harryiliffe/interactive-wall/README.md

# Interactive Wall
A flexible system for creating an interactive wall
