harryiliffe/interactive-wall/docs/_pages/language.md

---
title: "Language"
layout: default
---

# Interactive Wall component names

##### Module
Each individual physical component.
e.g Button Module, Hub Module e.t.c.

##### Compute Hub
esp32 + power regulation

##### Capacitive Hub
Capacitive touch board

##### Button
The module that has the capacitive touch button and workshop title.

# Fab Lab WGTN sessions

### Intros
 * about fab tour
 * designing for additive and subtractive
 * open blogging
 * illustrator for digital fabrication

 * intro to laser cutting

 * intro to 3d printing
 * intro to digital embroidery
 * intro to glitch knit
 * cnc milling software
 * cnc milling wax mill
 * cnc milling shopbot
 * intro to tensile tester
 * intro to electronics
 * intro to programming
 * intro to 3d scanning
 * intro to vinyl cutting
 * circuit design and production

### Machines

 * vinyl cutter
 * laser cutter
 * 3d printer
 * MDX-40
 * MDX-20
 * embroidery machine
 * glitch knit
 * 3d scanner
 * tensile tester
