harryiliffe/interactive-wall/boards/button module/exports/button-v1-mask.png

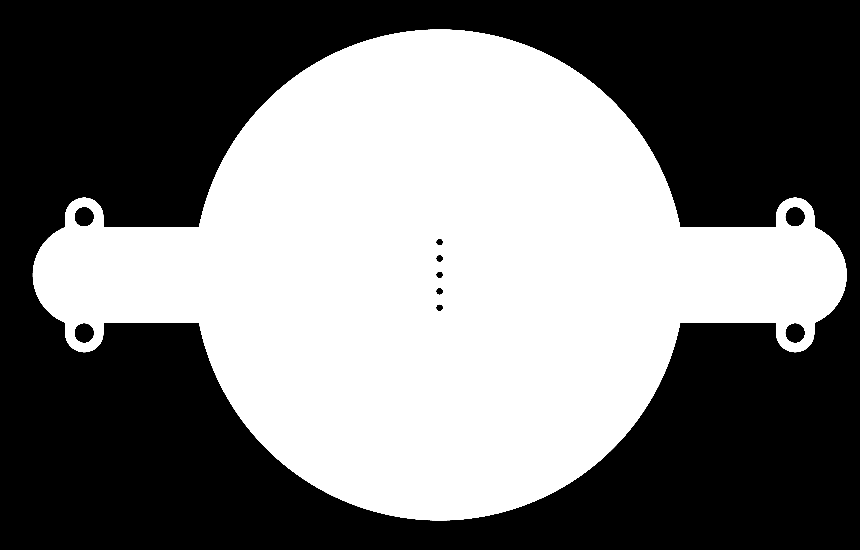
boards/button module/exports/button-v1-mask.png
