harryiliffe/interactive-wall/boards/button module/exports/button-v1-trace.png

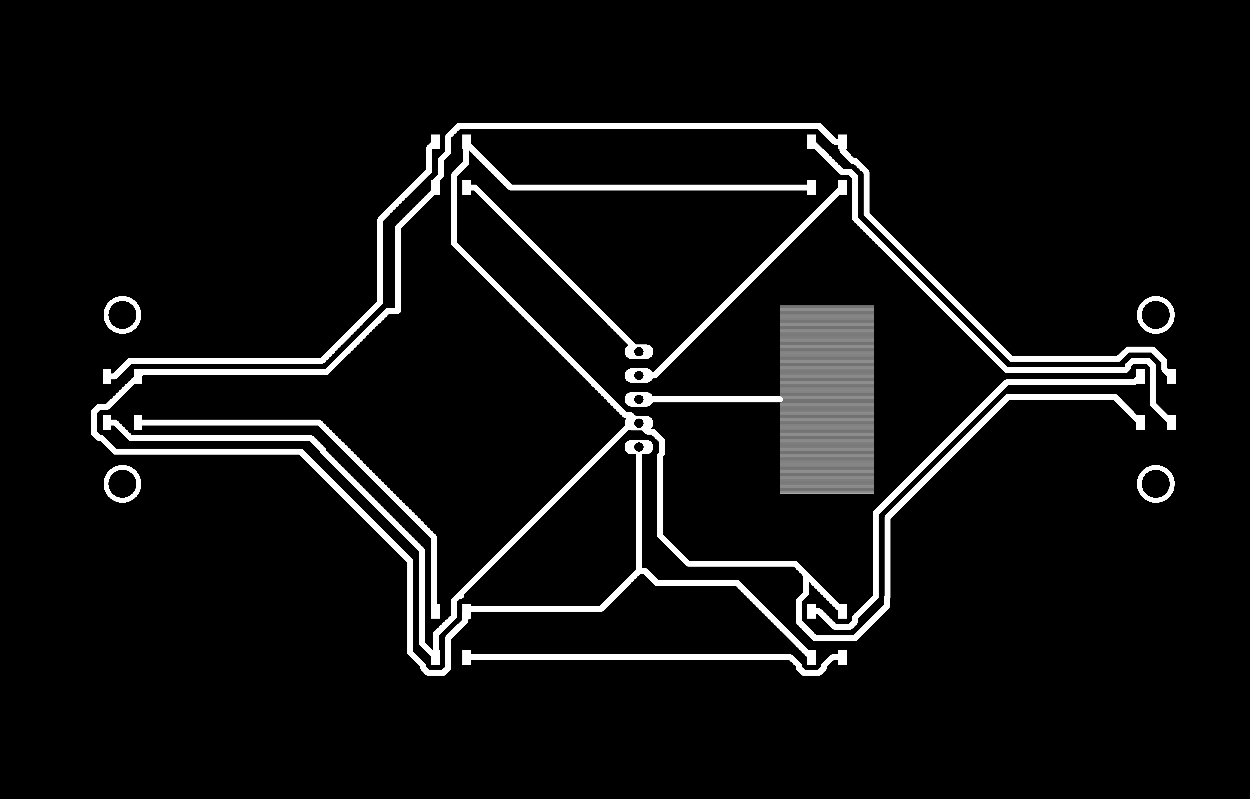
boards/button module/exports/button-v1-trace.png
