harryiliffe/interactive-wall/boards/button module/exports/button-v2-mask.png

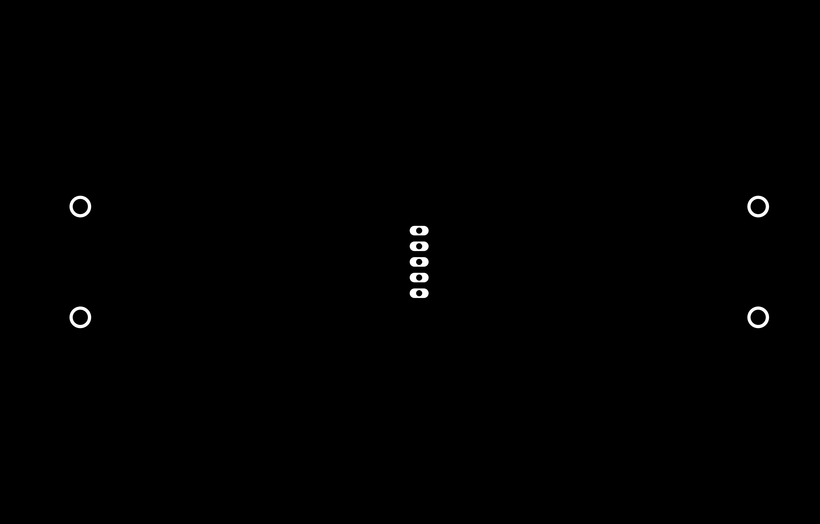
boards/button module/exports/button-v2-mask.png
