harryiliffe/interactive-wall/boards/button module/exports/button-v2-trace.png

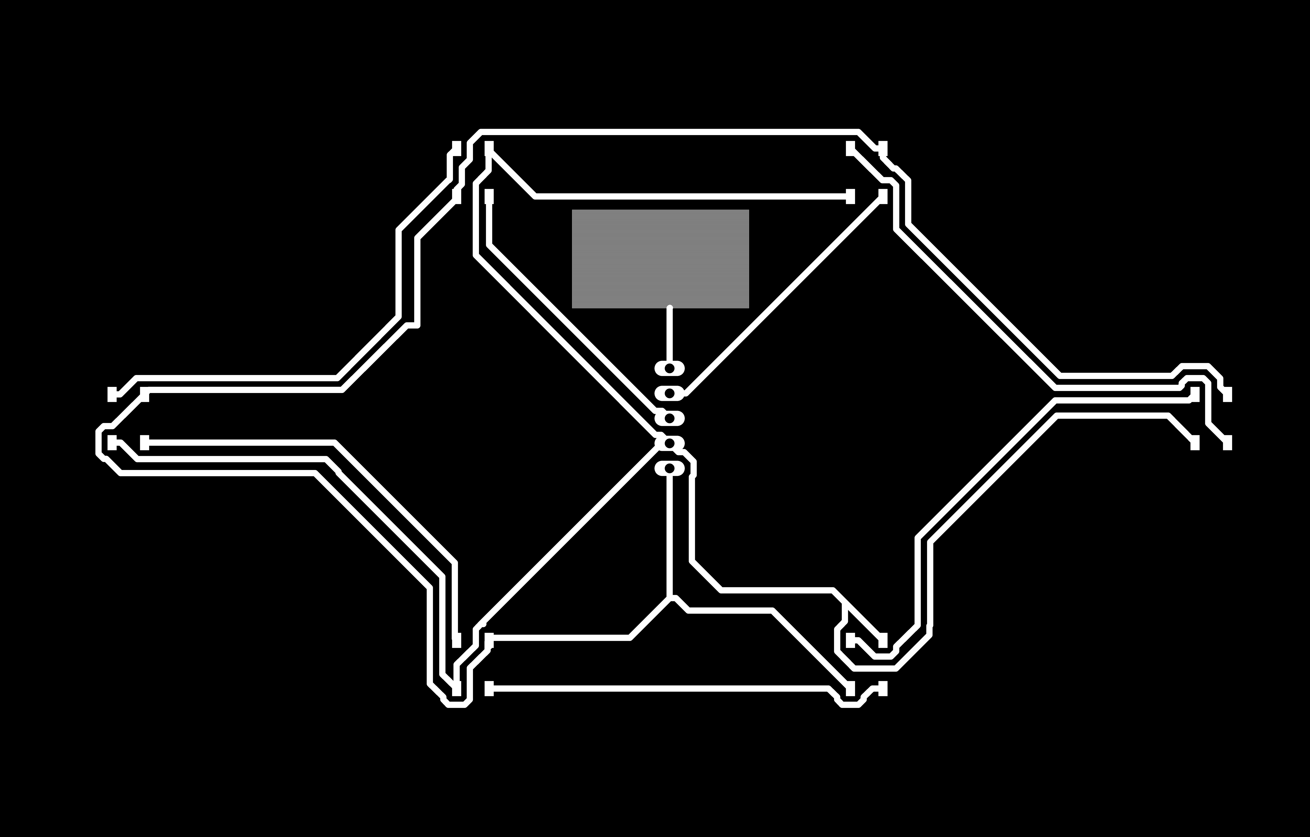
boards/button module/exports/button-v2-trace.png
