harryiliffe/interactive-wall/boards/capactive hub/export/cap_hub-v1-mask.png

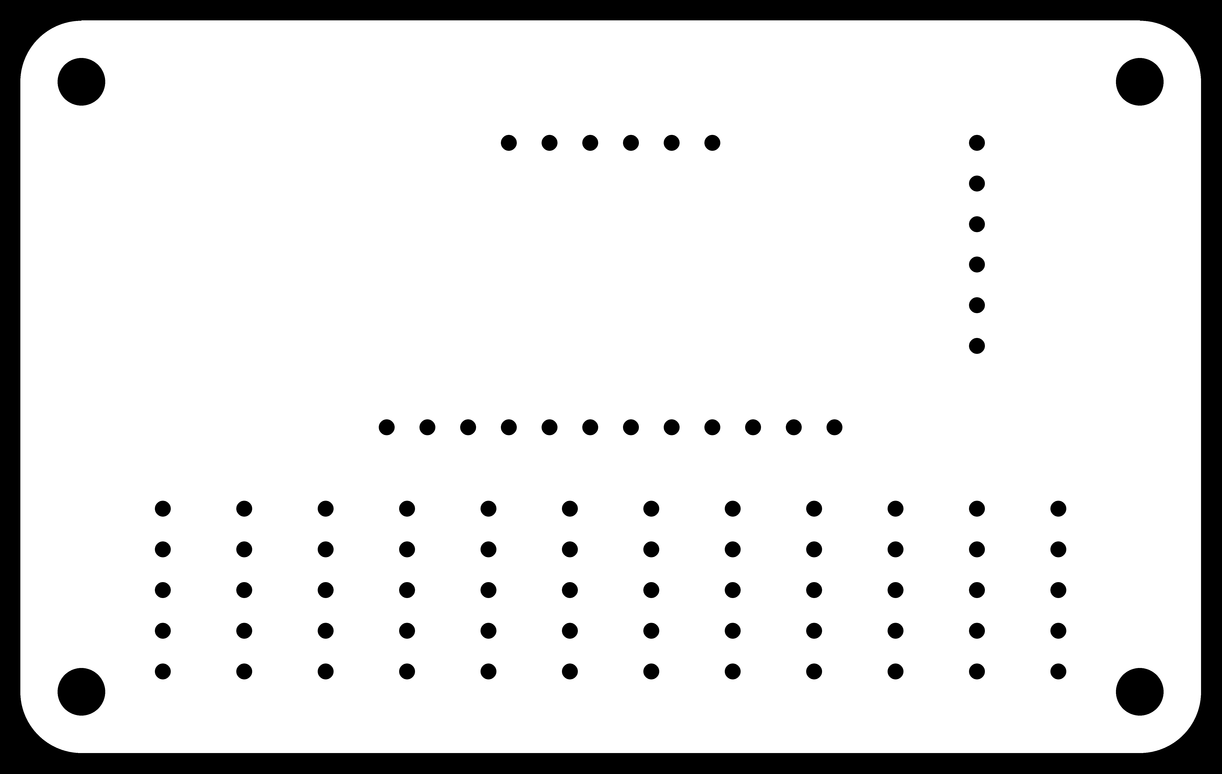
boards/capactive hub/export/cap_hub-v1-mask.png
