harryiliffe/interactive-wall/boards/capactive hub/export/cap_hub-v1-trace.png

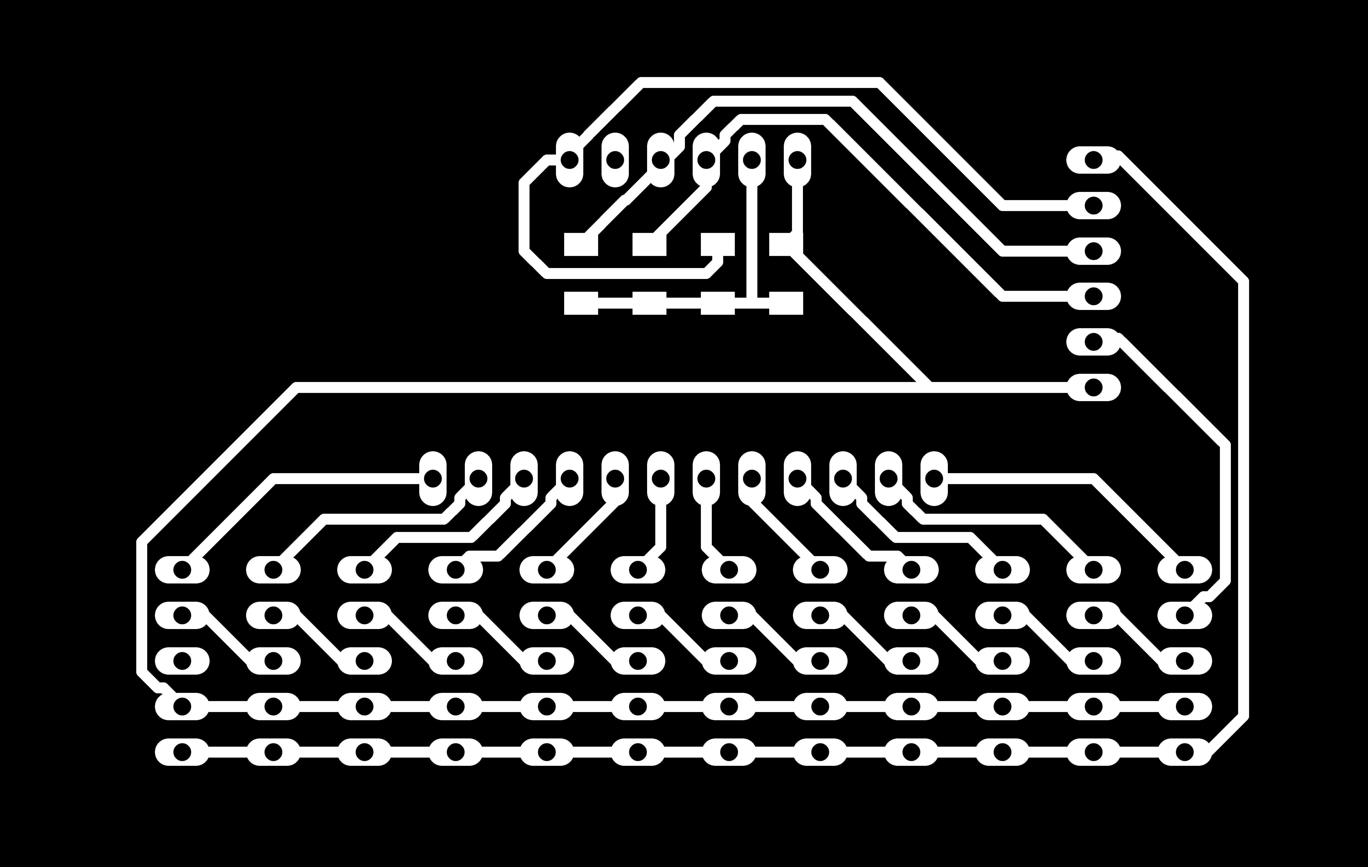
boards/capactive hub/export/cap_hub-v1-trace.png
