harryiliffe/interactive-wall/boards/capactive hub/export/cap_hub-v2-trace.png

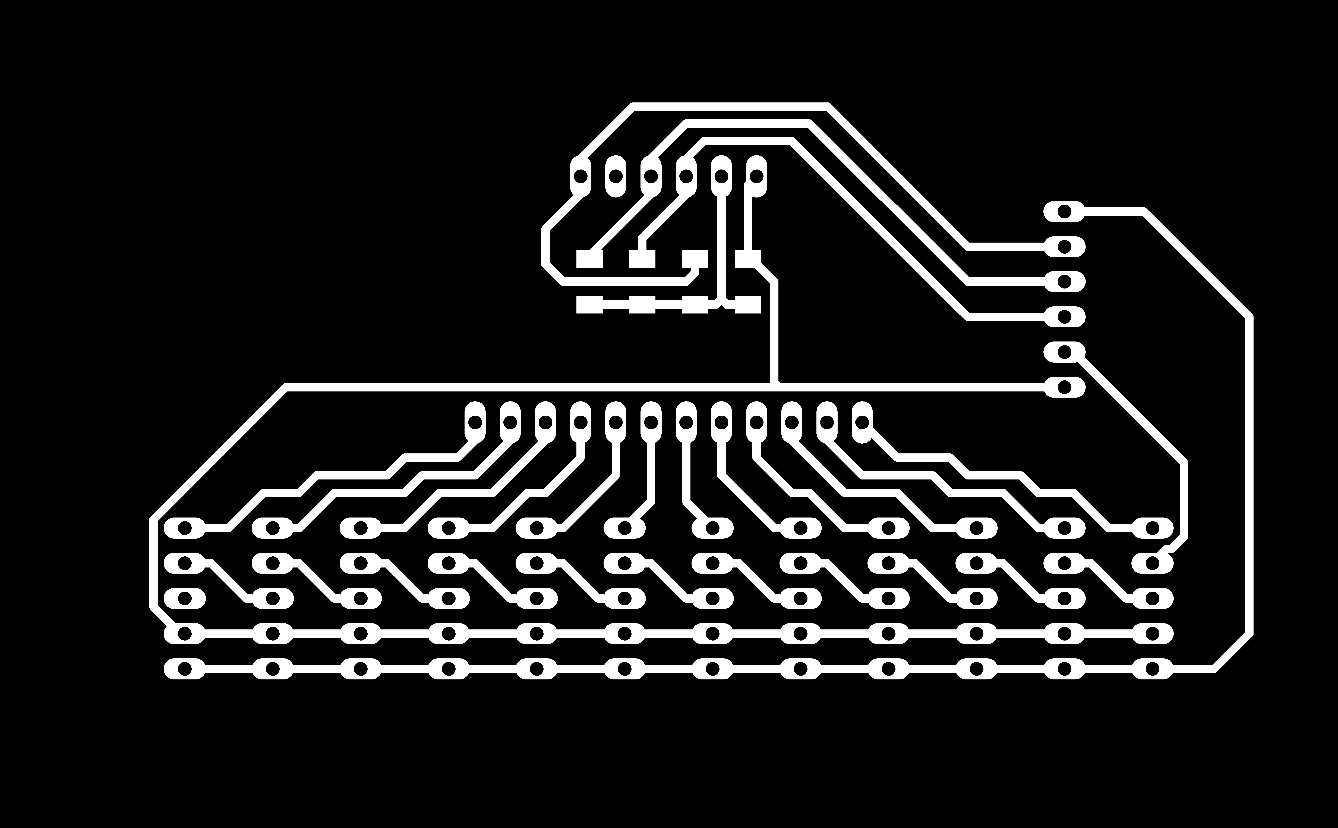
boards/capactive hub/export/cap_hub-v2-trace.png
