harryiliffe/interactive-wall/boards/compute hub - atmega/exports/computehub.png

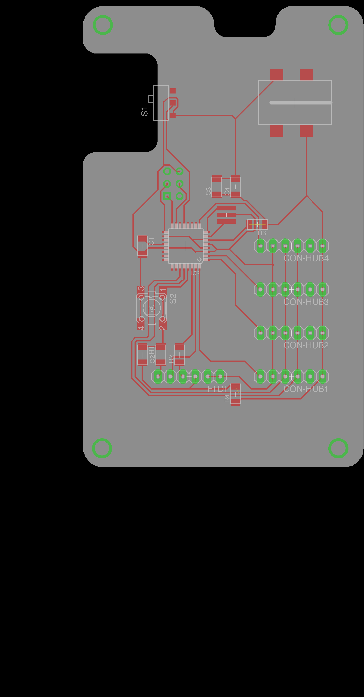
boards/compute hub - atmega/exports/computehub.png
