harryiliffe/interactive-wall/boards/compute hub - atmega/minimal circuit.png

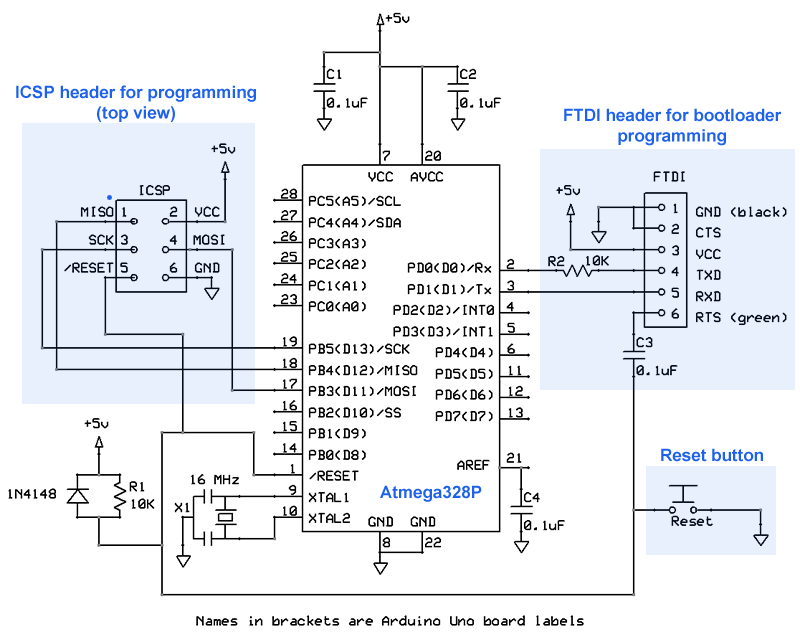
boards/compute hub - atmega/minimal circuit.png
