harryiliffe/interactive-wall/boards/compute hub/exports/compute_hub-v1-mask.png

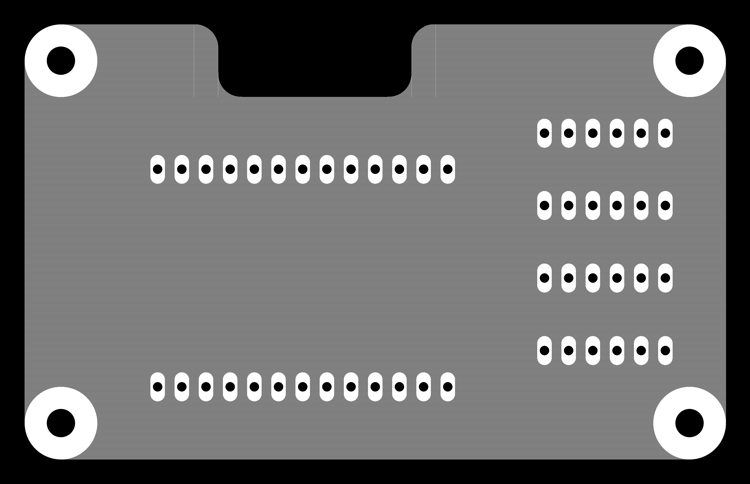
boards/compute hub/exports/compute_hub-v1-mask.png
