harryiliffe/interactive-wall/boards/compute hub/exports/compute_hub-v1-trace.png

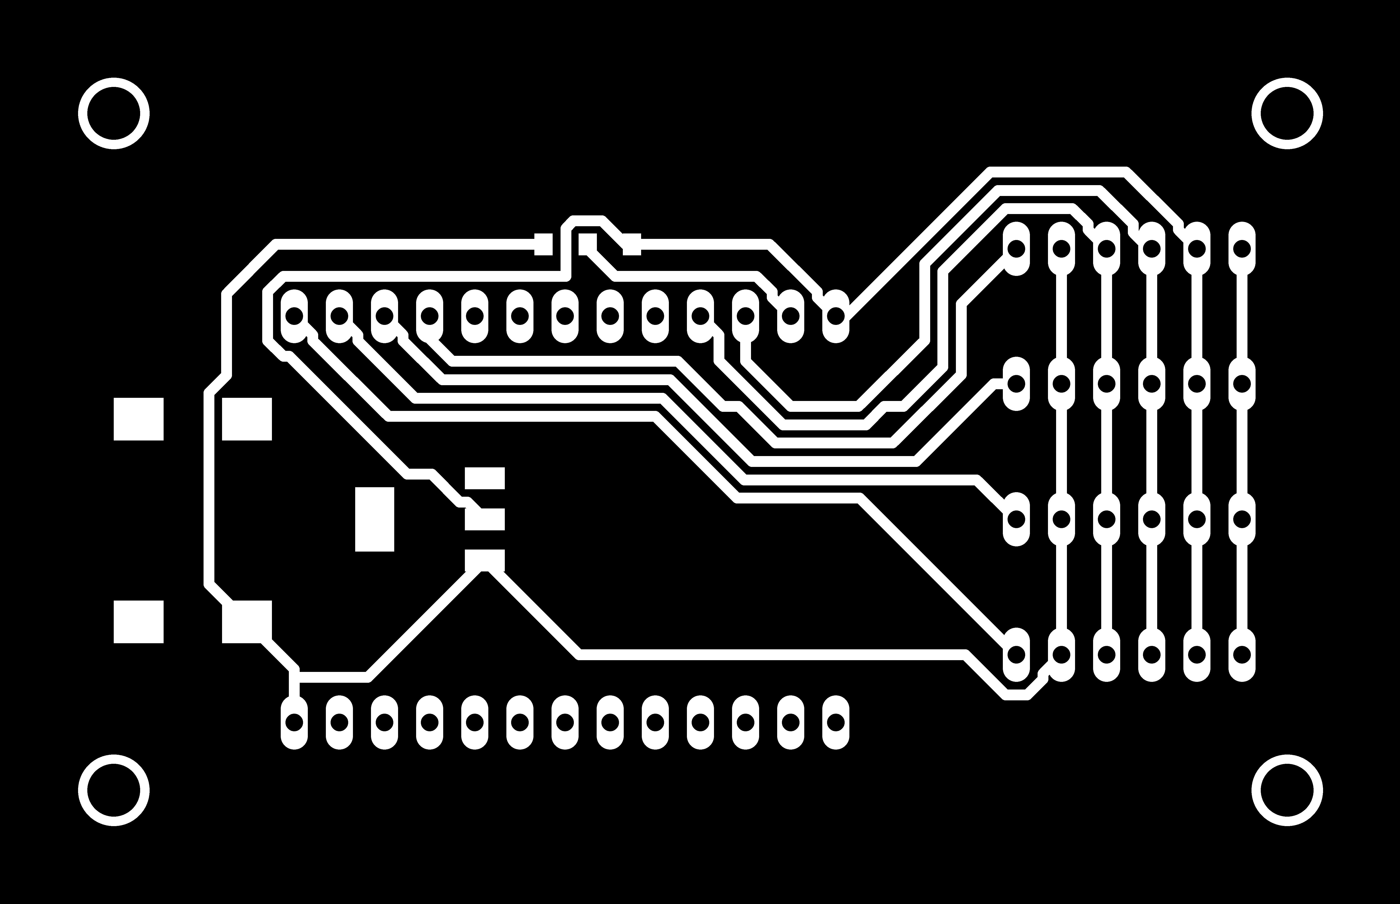
boards/compute hub/exports/compute_hub-v1-trace.png
