harryiliffe/interactive-wall/boards/compute hub/exports/compute_hub-v2-mask.png

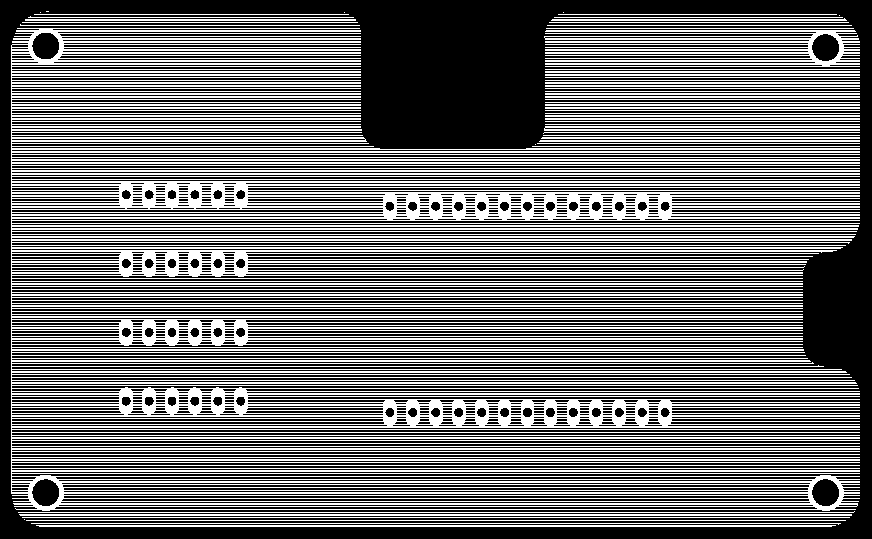
boards/compute hub/exports/compute_hub-v2-mask.png
