harryiliffe/interactive-wall/boards/compute hub/exports/compute_hub-v2-trace.png

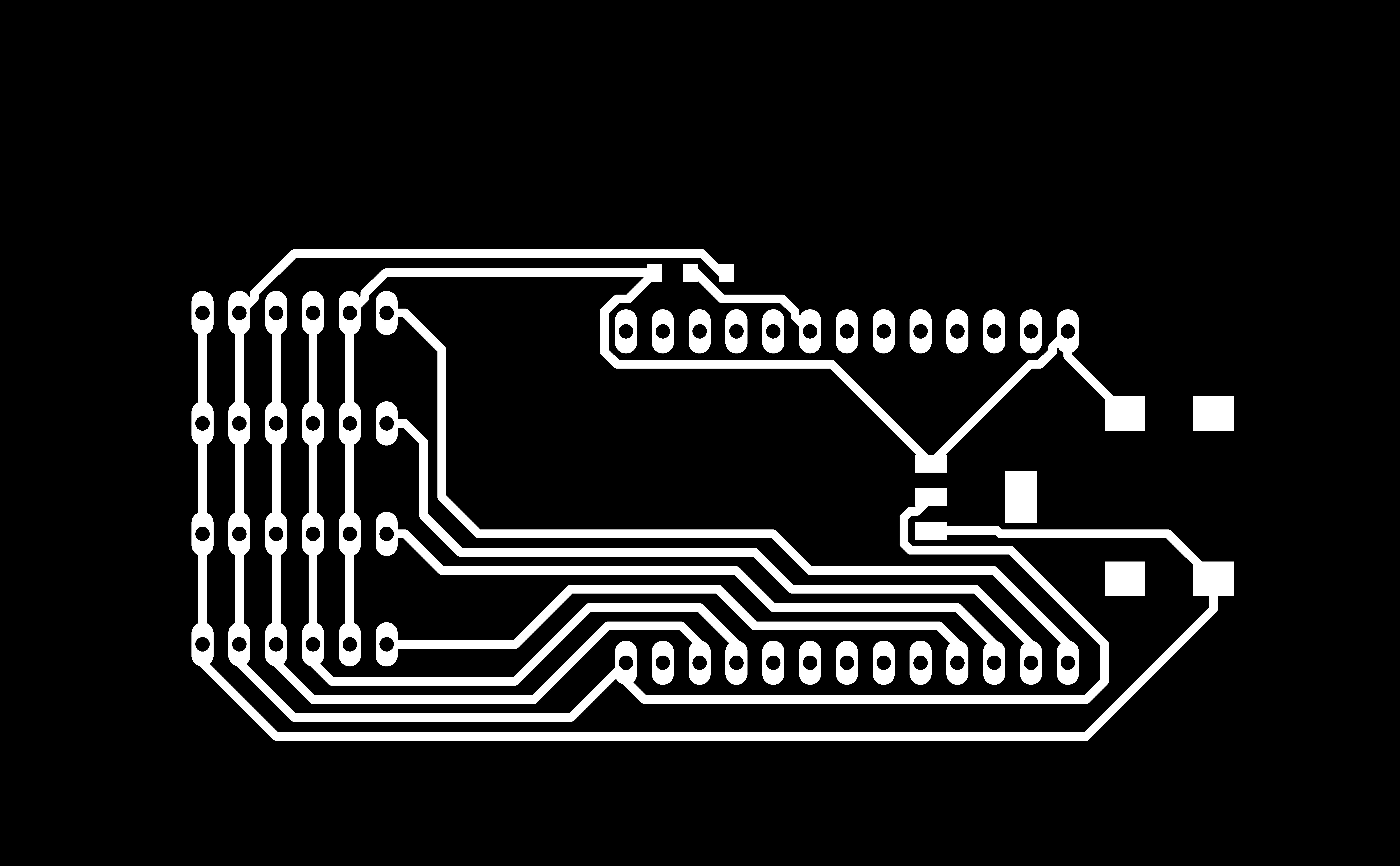
boards/compute hub/exports/compute_hub-v2-trace.png
