harryiliffe/interactive-wall/boards/led bar/export/led_bar-v2-mask.png

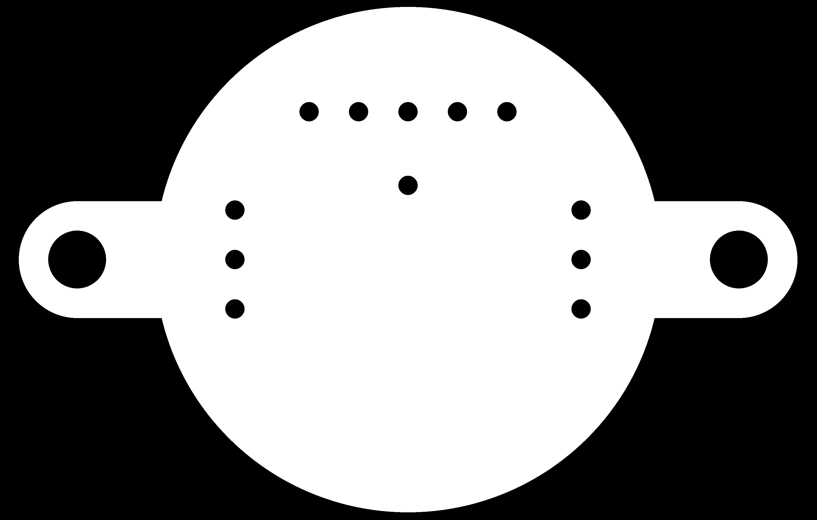
boards/led bar/export/led_bar-v2-mask.png
