harryiliffe/interactive-wall/boards/led bar/export/led_bar-v2-trace.png

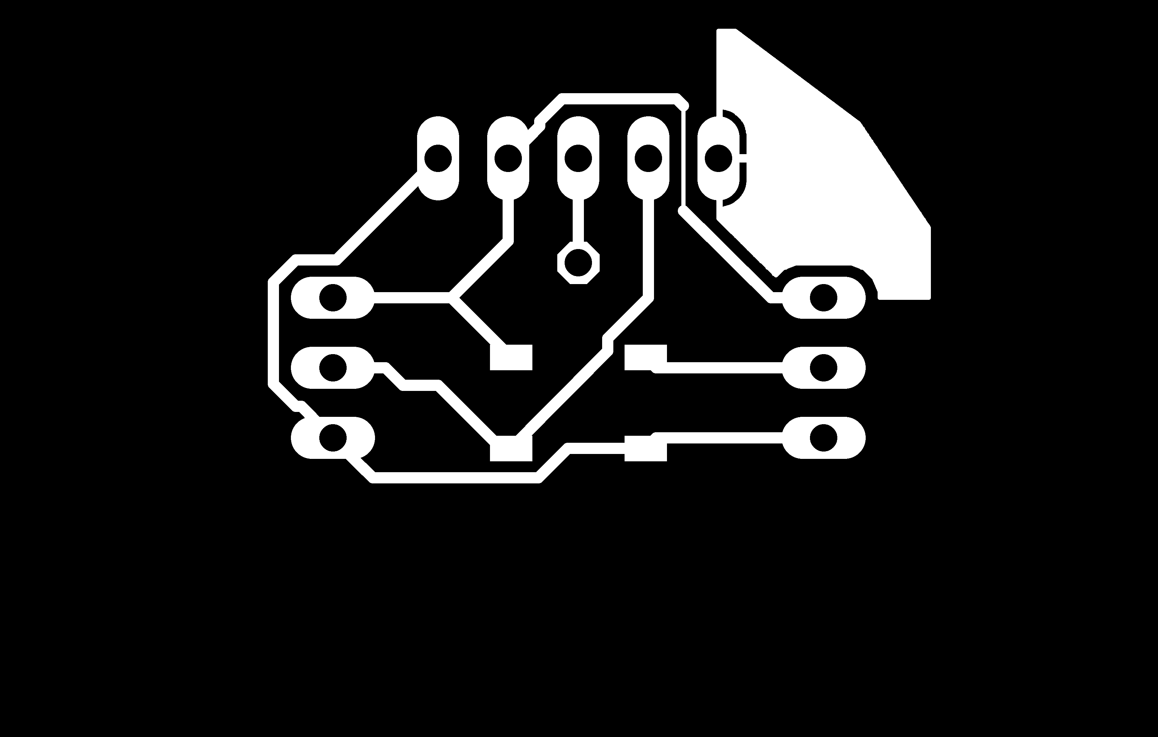
boards/led bar/export/led_bar-v2-trace.png
