harryiliffe/interactive-wall/boards/led bar/export/mask1.png

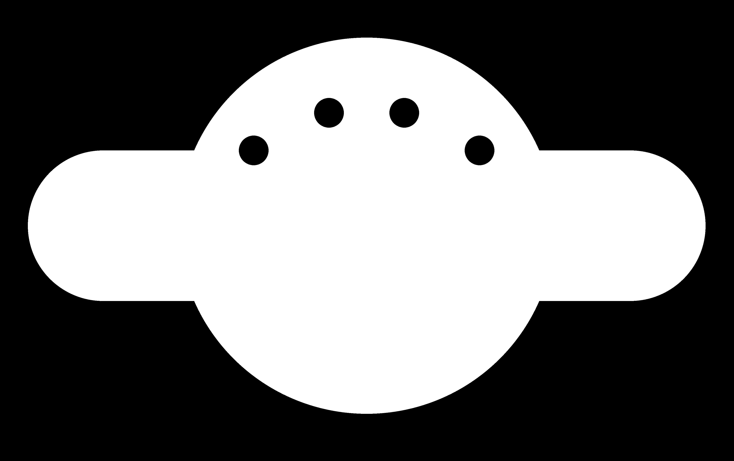
boards/led bar/export/mask1.png
