harryiliffe/interactive-wall/boards/led bar/export/trace1-edited.png

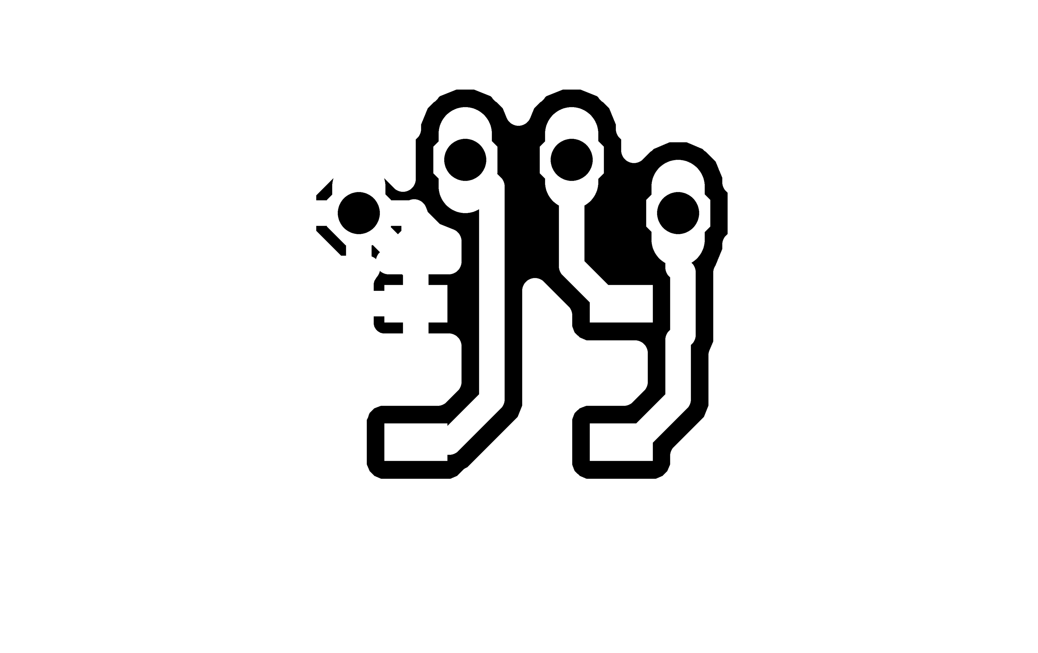
boards/led bar/export/trace1-edited.png
