harryiliffe/interactive-wall/boards/led bar/export/trace1.png

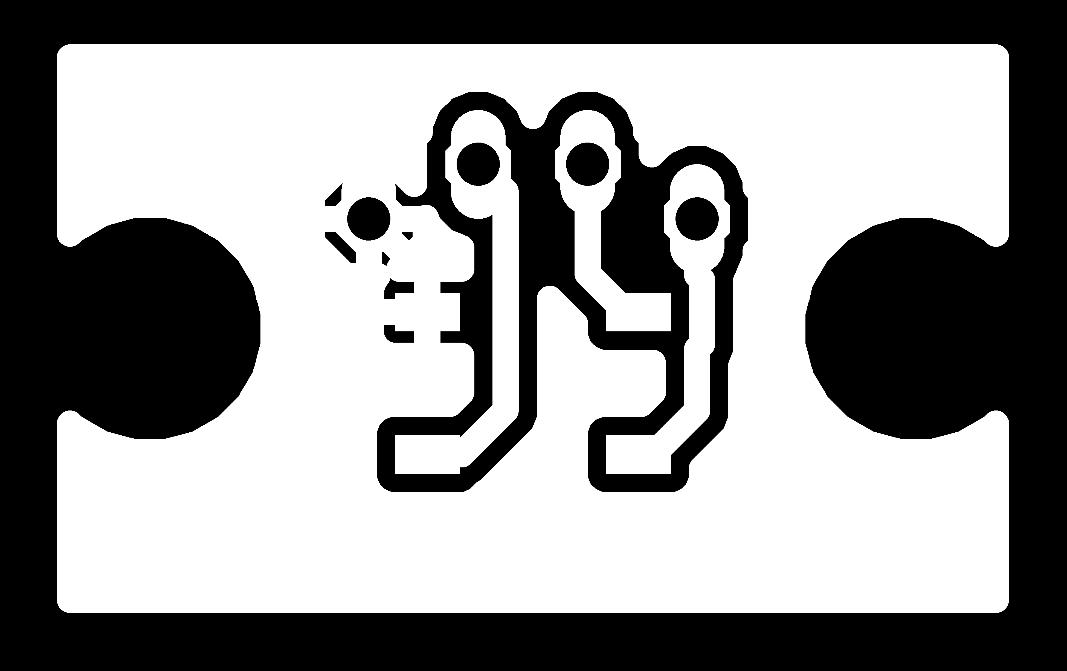
boards/led bar/export/trace1.png
