harryiliffe/interactive-wall/docs/assets/img/buttoncopper.jpg

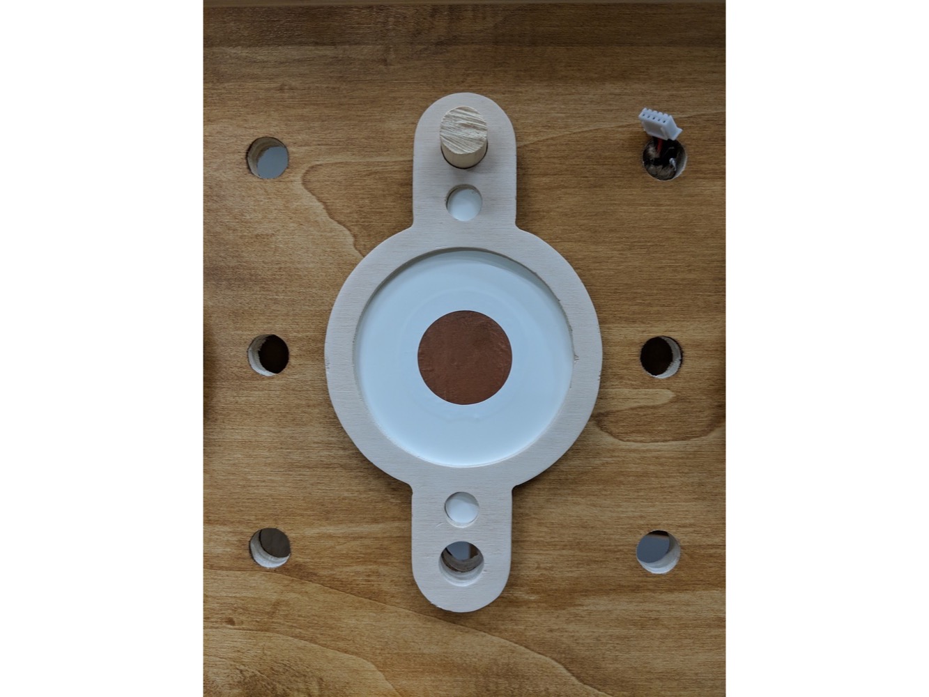
docs/assets/img/buttoncopper.jpg
