harryiliffe/interactive-wall/docs/assets/img/buttonfelt.jpg

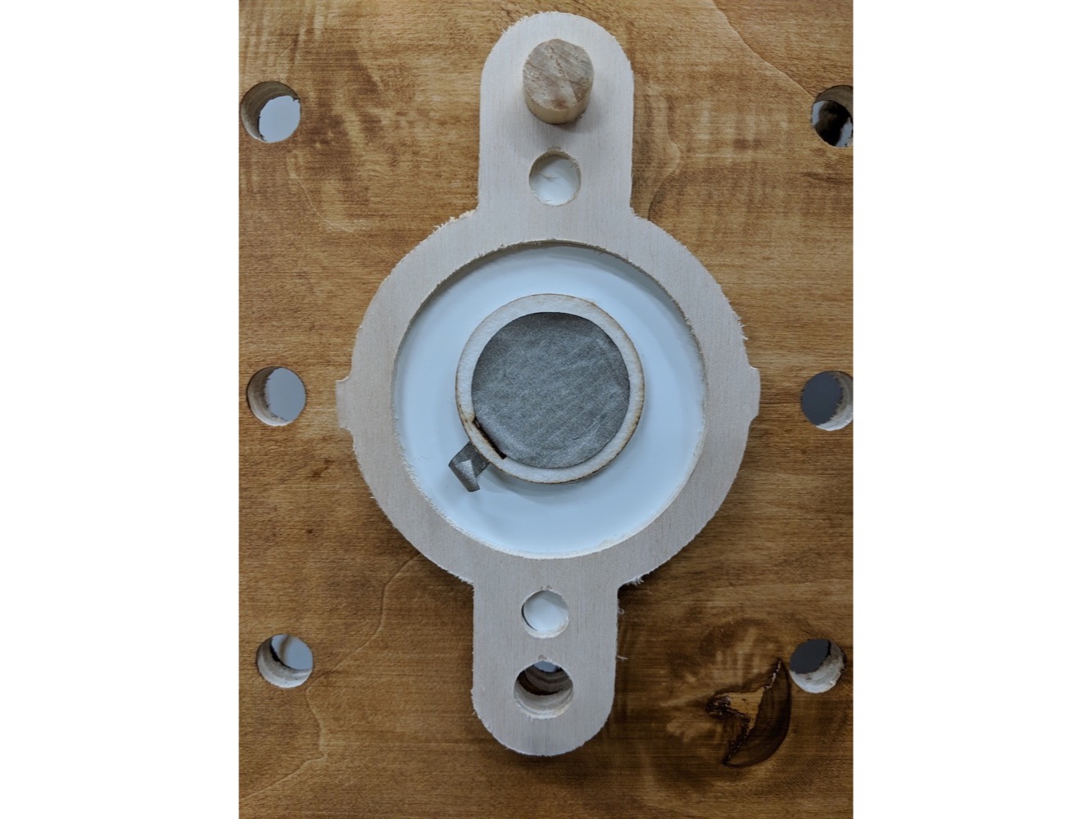
docs/assets/img/buttonfelt.jpg
