harryiliffe/interactive-wall/docs/assets/img/buttonshiny.jpg

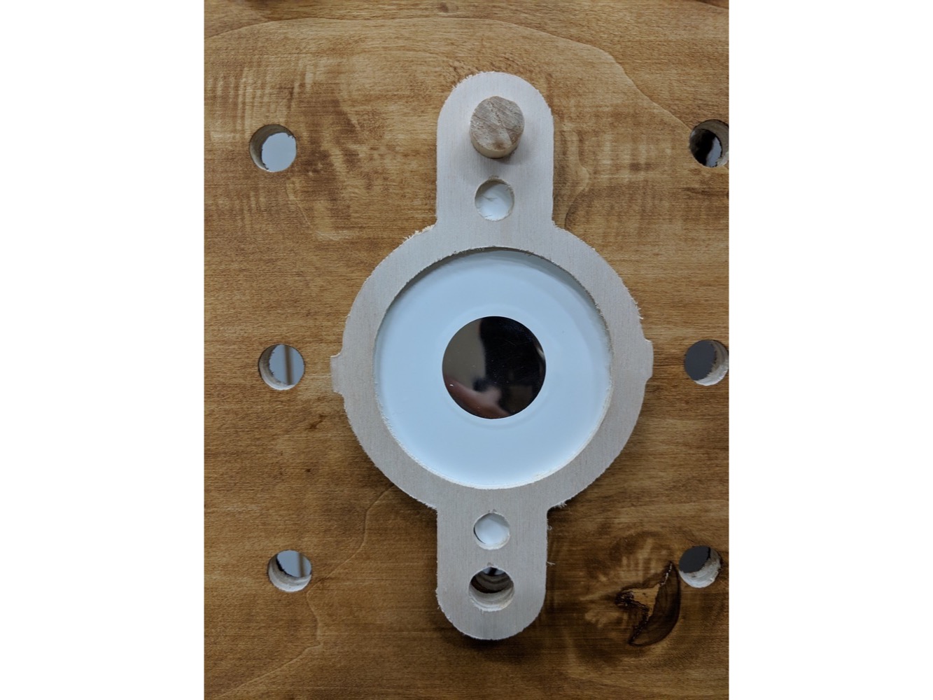
docs/assets/img/buttonshiny.jpg
