harryiliffe/interactive-wall/docs/assets/img/electronics1.jpg

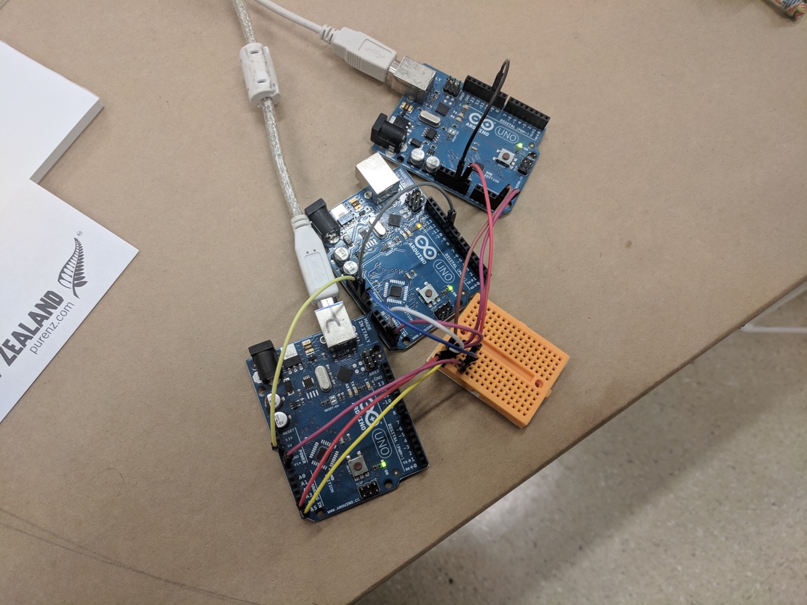
docs/assets/img/electronics1.jpg
