harryiliffe/interactive-wall/docs/assets/img/electronics2.jpg

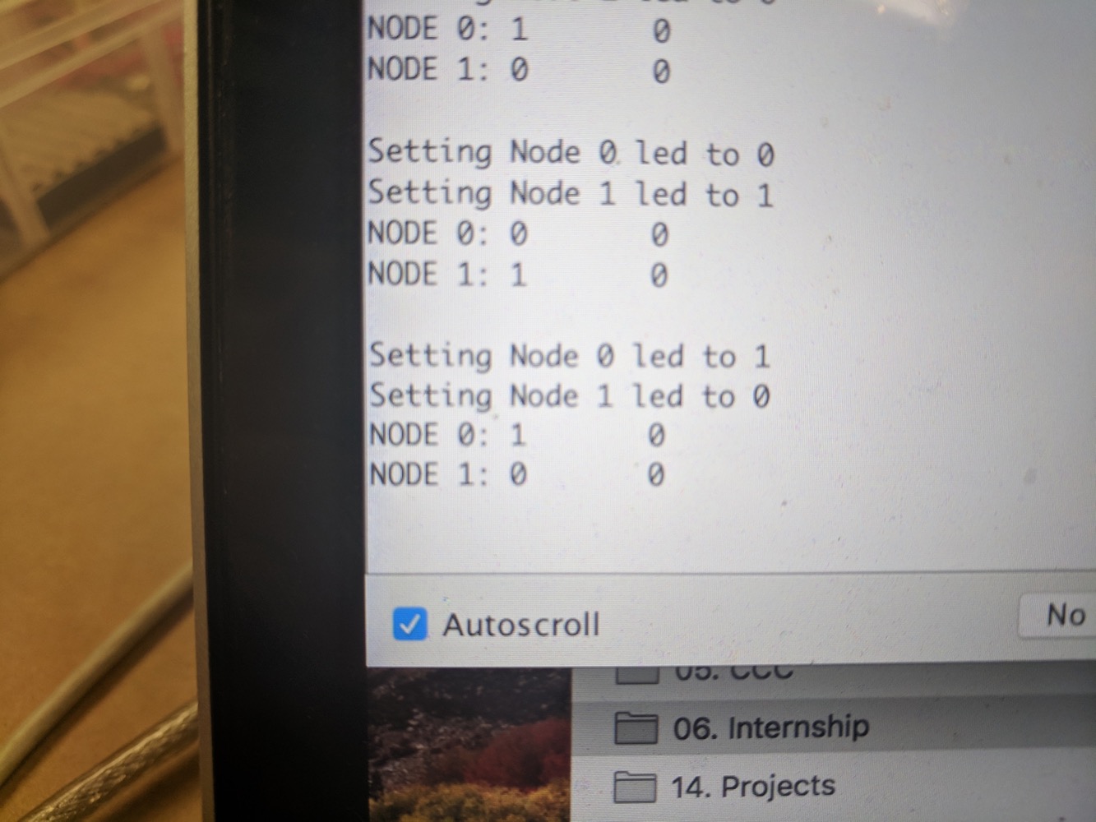
docs/assets/img/electronics2.jpg
