harryiliffe/interactive-wall/docs/assets/img/electronics3.jpg

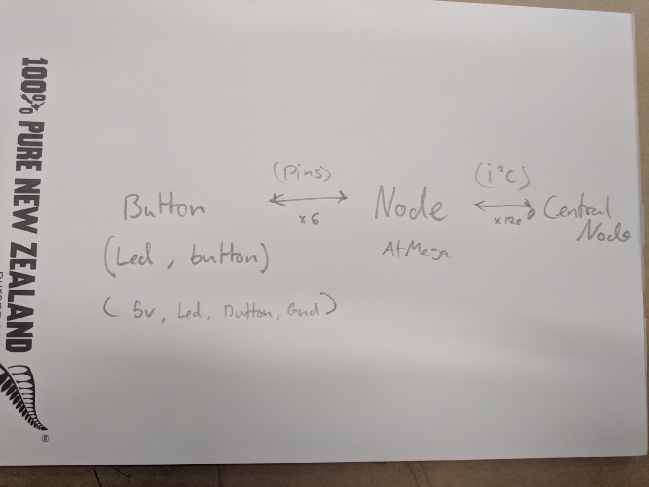
docs/assets/img/electronics3.jpg
