harryiliffe/interactive-wall/docs/assets/img/electronics4.jpg

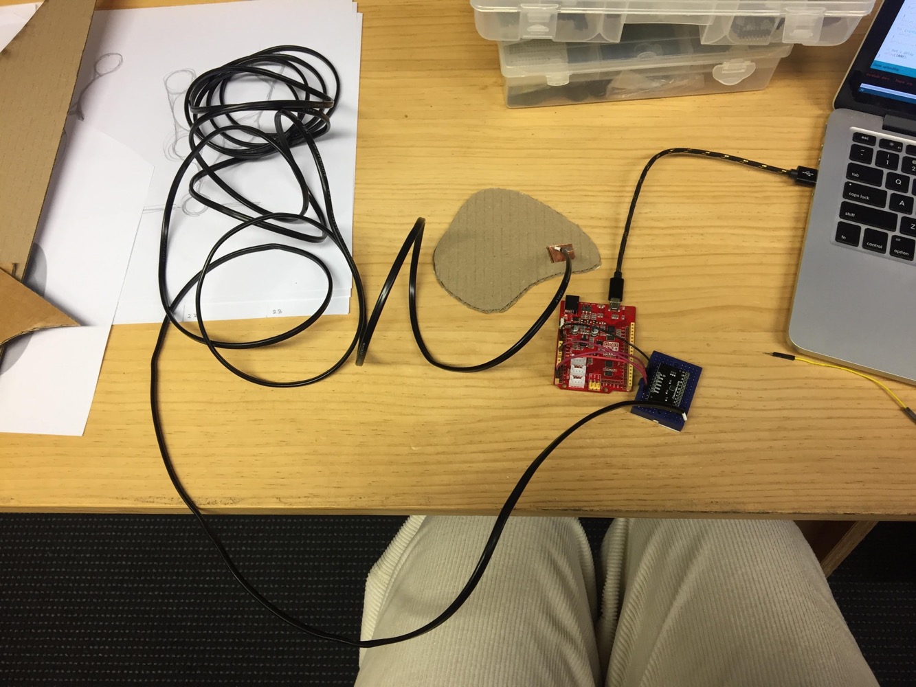
docs/assets/img/electronics4.jpg
