harryiliffe/interactive-wall/docs/assets/img/form_sketch_1.png

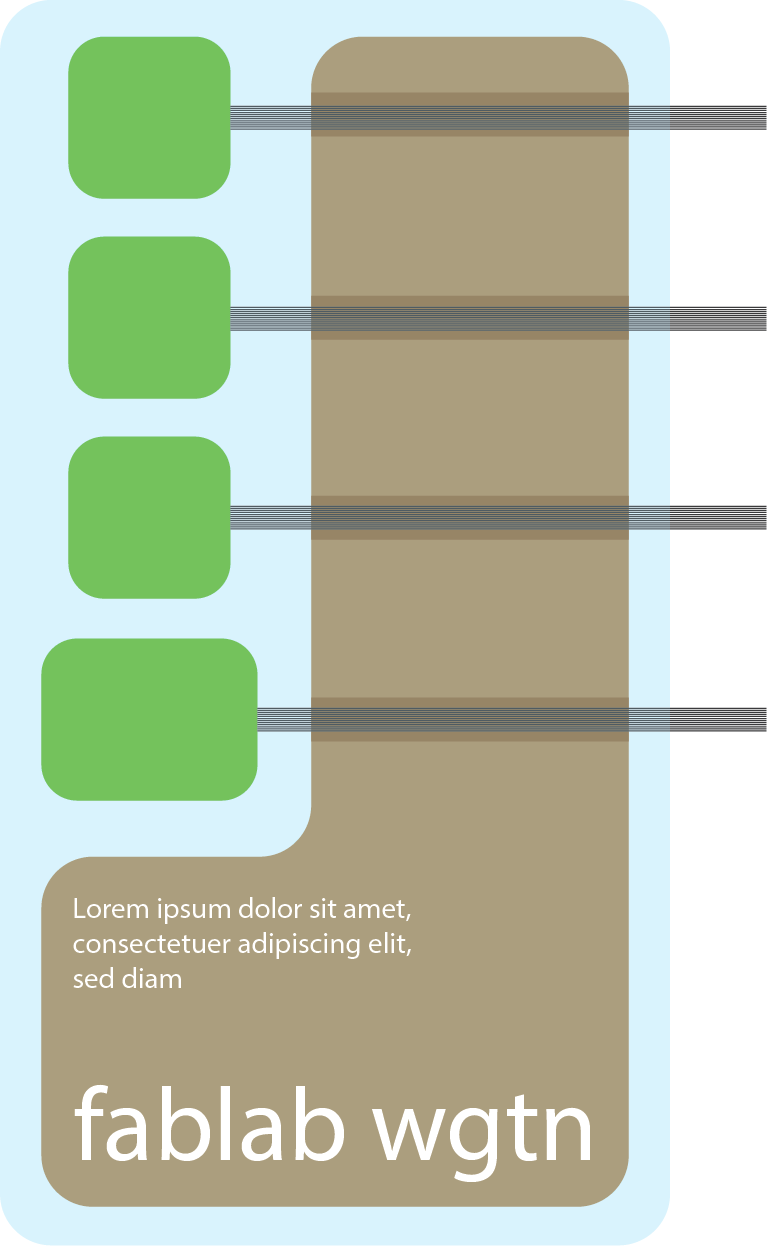
docs/assets/img/form_sketch_1.png
