harryiliffe/interactive-wall/docs/assets/img/form_sketch_3.png

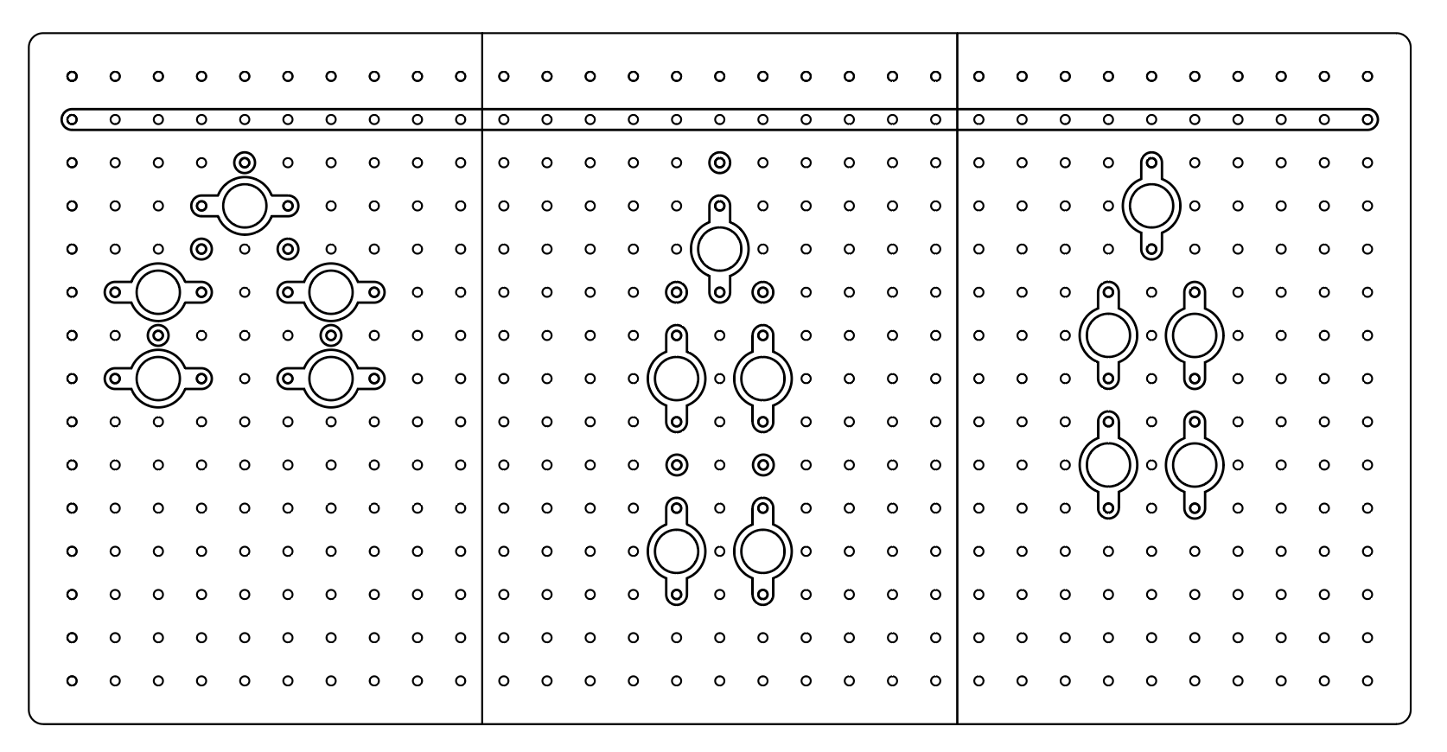
docs/assets/img/form_sketch_3.png
