harryiliffe/interactive-wall/docs/assets/img/form_sketch_4.png

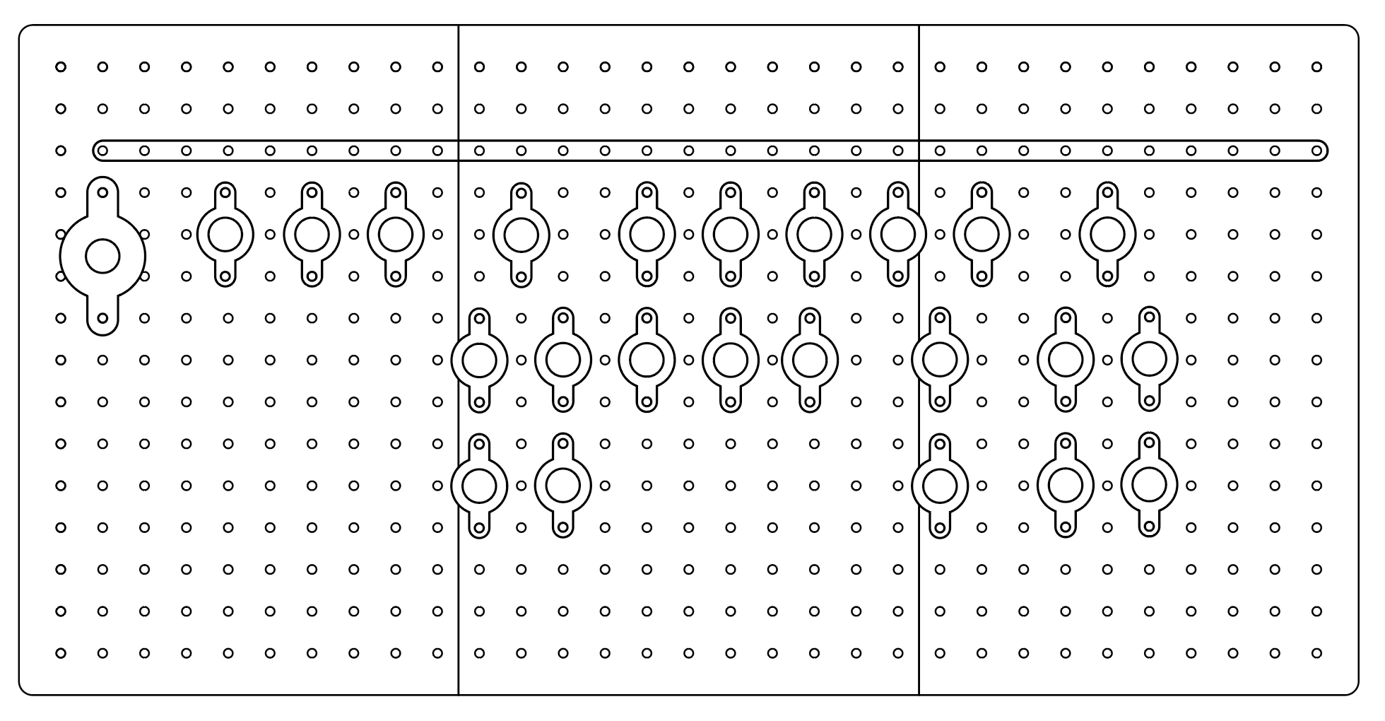
docs/assets/img/form_sketch_4.png
