harryiliffe/interactive-wall/docs/assets/img/paper1.jpg

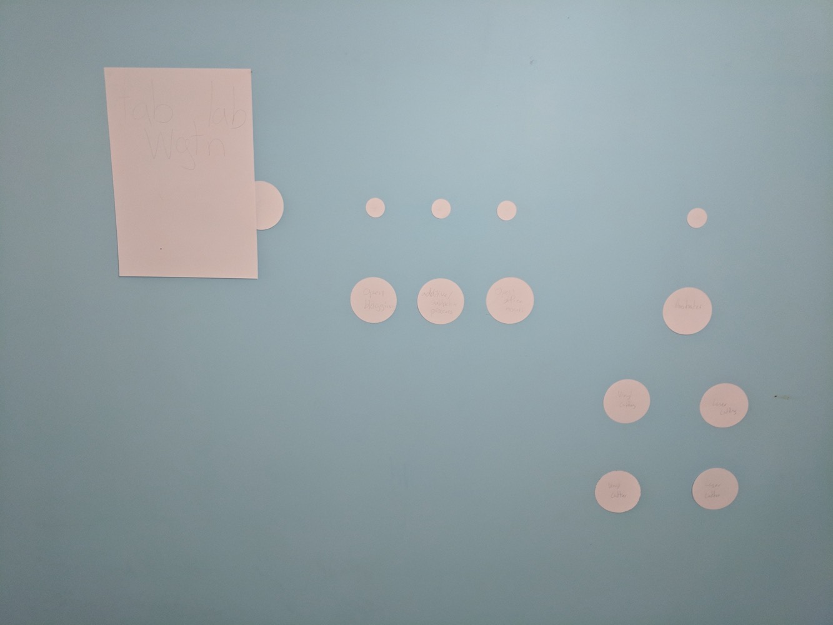
docs/assets/img/paper1.jpg
