harryiliffe/interactive-wall/docs/assets/img/paper2.jpg

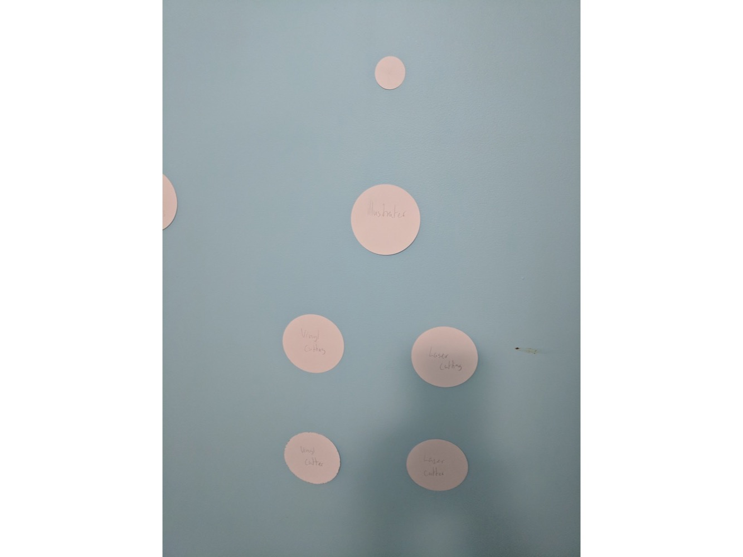
docs/assets/img/paper2.jpg
