harryiliffe/interactive-wall/docs/assets/img/paper3.jpg

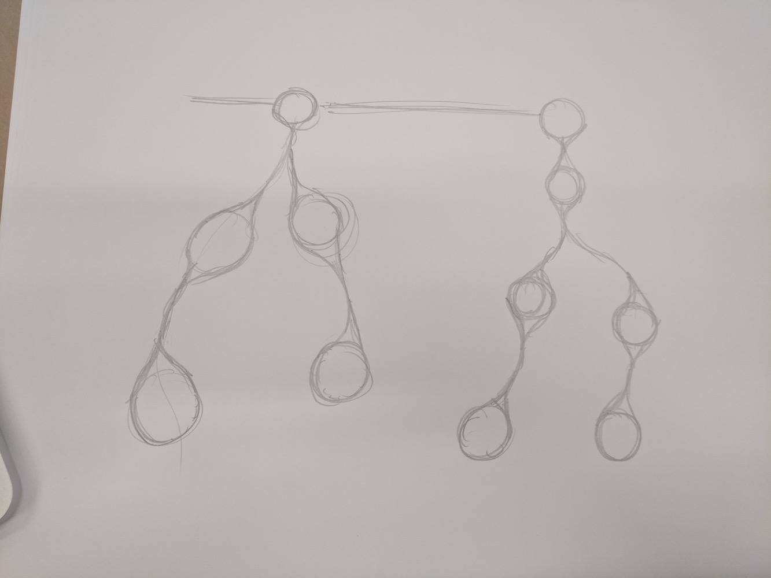
docs/assets/img/paper3.jpg
