harryiliffe/interactive-wall/docs/assets/img/paper4.jpg

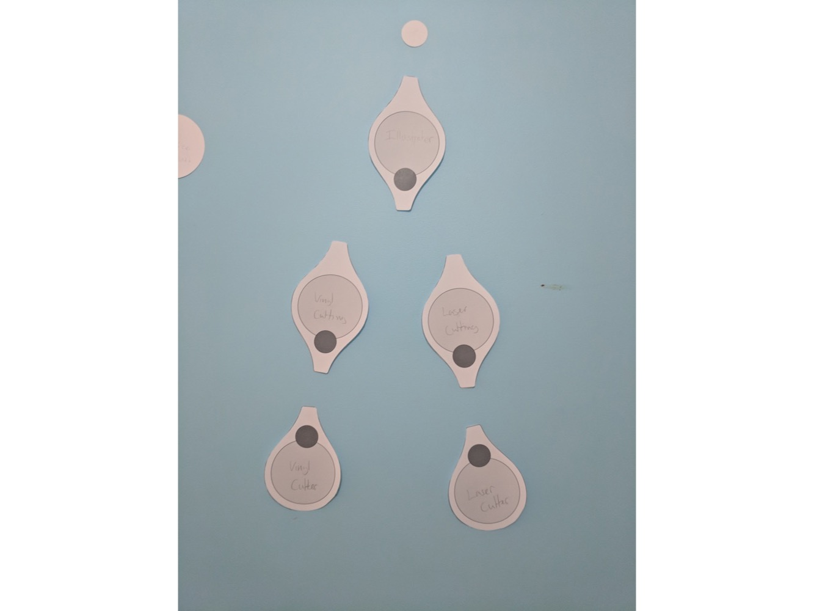
docs/assets/img/paper4.jpg
