harryiliffe/interactive-wall/docs/assets/img/paper5.jpg

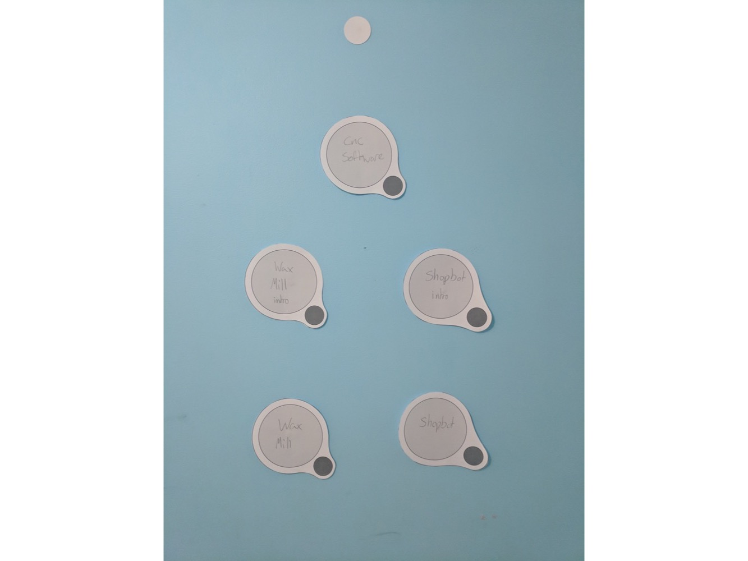
docs/assets/img/paper5.jpg
