harryiliffe/interactive-wall/docs/assets/img/paper6.jpg

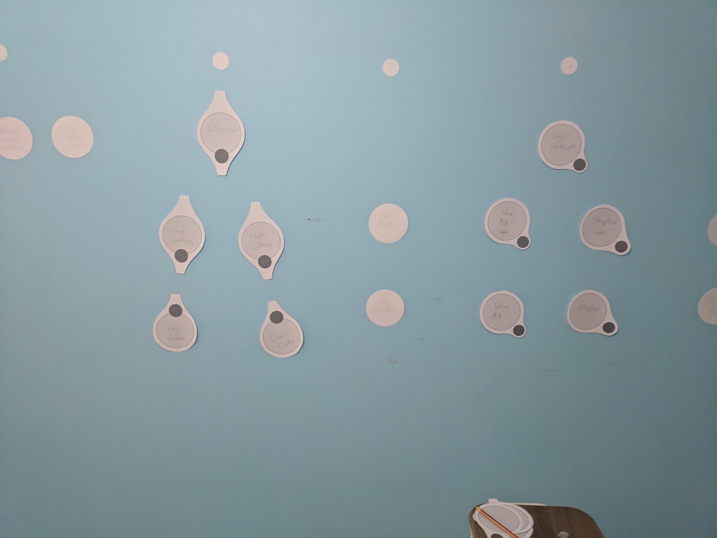
docs/assets/img/paper6.jpg
