harryiliffe/interactive-wall/docs/assets/img/paper7.jpg

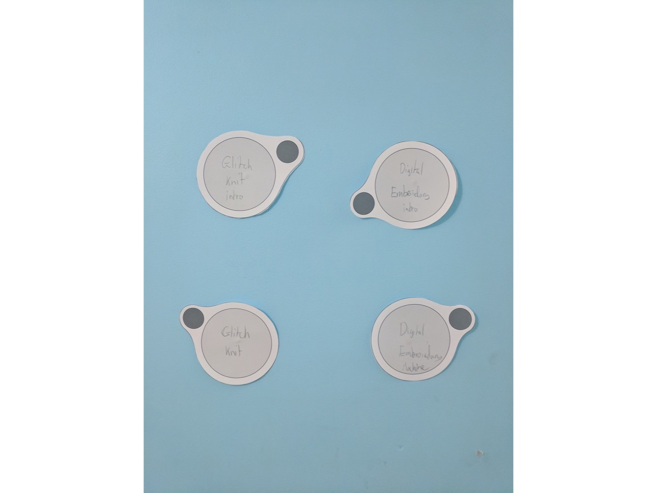
docs/assets/img/paper7.jpg
