harryiliffe/interactive-wall/docs/assets/img/paper8.jpg

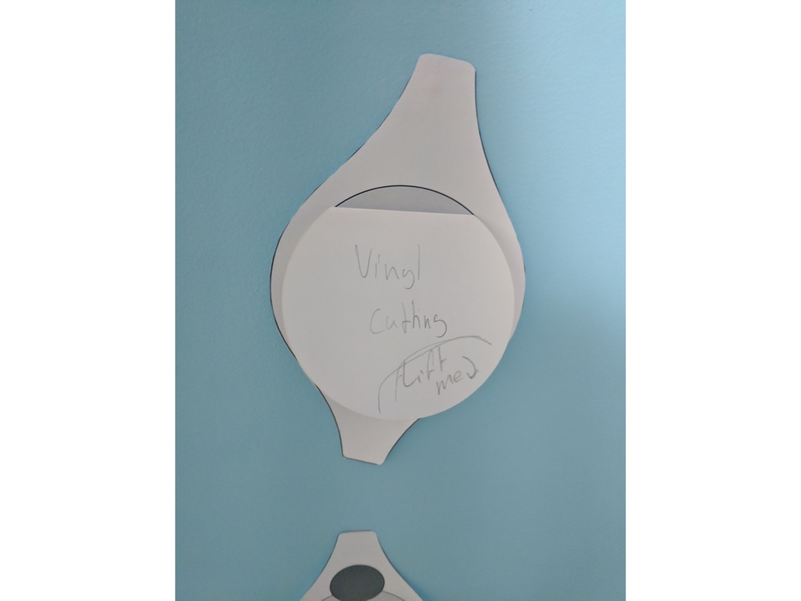
docs/assets/img/paper8.jpg
