harryiliffe/interactive-wall/docs/_pages/materials.md

---
title: "List of Materials"
layout: default
---
# List of Materials

### Sheet Materials
 * Plywood (12mm)
 * Acrylic (Clear Green Edge 3mm)
 * FR1 (Single Sided Copper Board)
 * Copper Foil (Self-Adhesive)
 * Vinyl (Colours TBC)

### Electronics
 * [Wemos Lolin32 Lite (ESP32 based)](https://wiki.wemos.cc/products:lolin32:lolin32_lite)
 * MPR121 (Capacitive Touch Board) (1528-1038-ND)
 * [LEDs (WS2812B)](https://www.seeedstudio.com/document/pdf/WS2812B%20Datasheet.pdf) or WS2813 Leds
 * JST Connectors -

 * Wires

## Costs

Below is a link to the pricing list to assembly a full interactive wall.
This include 4 panels, 1 compute hub, 4 capacitive hubs, 24 buttons, 4 led bars, and 114 pegs.

[Pricing List](https://docs.google.com/spreadsheets/d/1MyzGQFx7wxgbCOXX1lHAo02ZbjRhZ3zoNsOl7Qcn5mM/edit?usp=sharing)
