harryiliffe/interactive-wall/docs/buildlog.md

# Build Log

What follows will hopefully be an unpretty flow of ideas that will eventually come together to form an interactive wall. Fingers crossed :)

## Goals

Some key goals for the project.
The finished project will
  * Communicates the sessions available
  * flexible, and easy to upgrade and change around in the future
  * be supported by full documentation, allowing for anyone to create their own interactive wall
  * be installed at Fab Lab WGTN

## Paper Prototyping

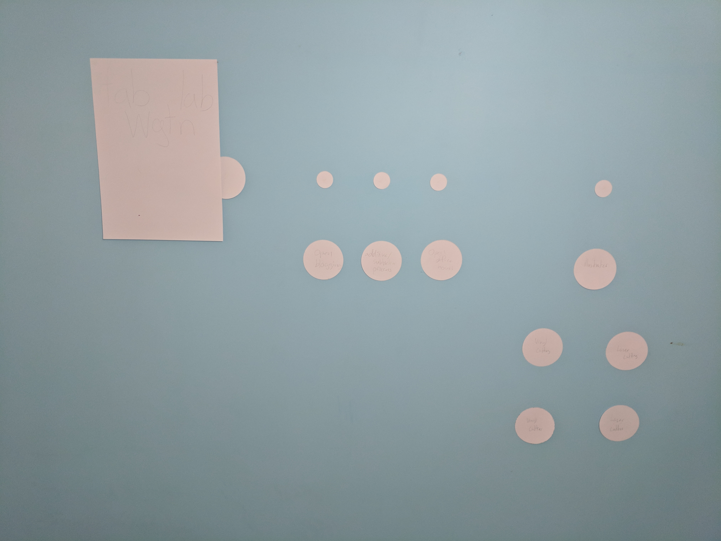
[picture p37: docs/assets/paper1.jpg]
paper1

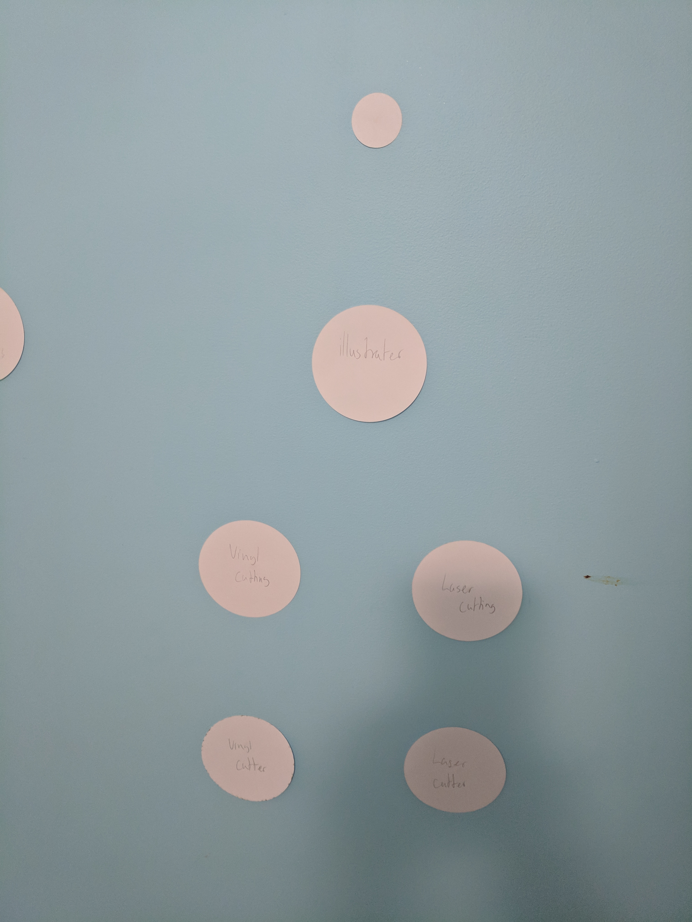
[picture p38: docs/assets/paper2.jpg]
paper2


Above is some images of the paper prototyping we did.
Both Liz and I quite like the layout shown in the photo as it can be nicely divided into different sections.

### Button Style

Trying out different button styles.
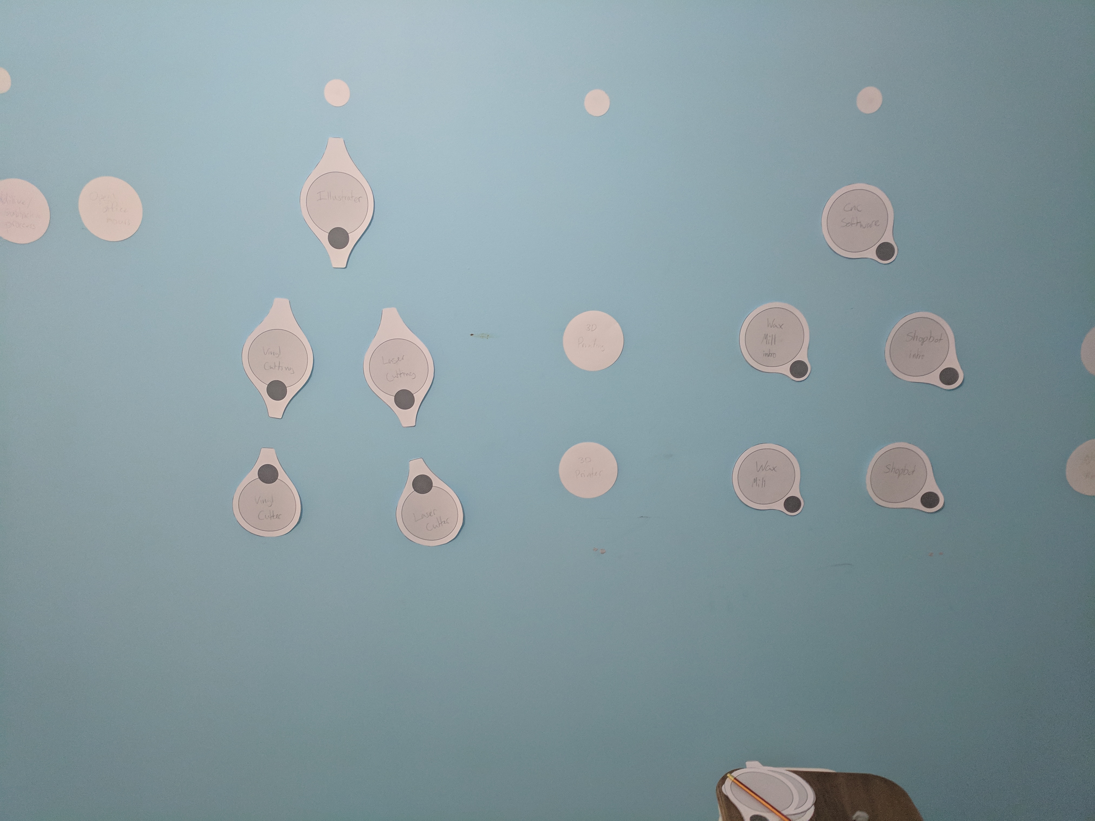
[picture p39: docs/assets/paper6.jpg]
paper6


The small dark circles are the pushable buttons.
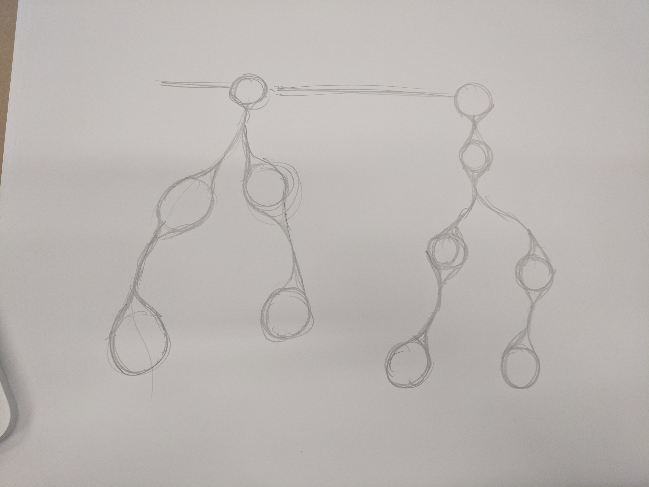
[picture p40: docs/assets/paper3.jpg]
paper3

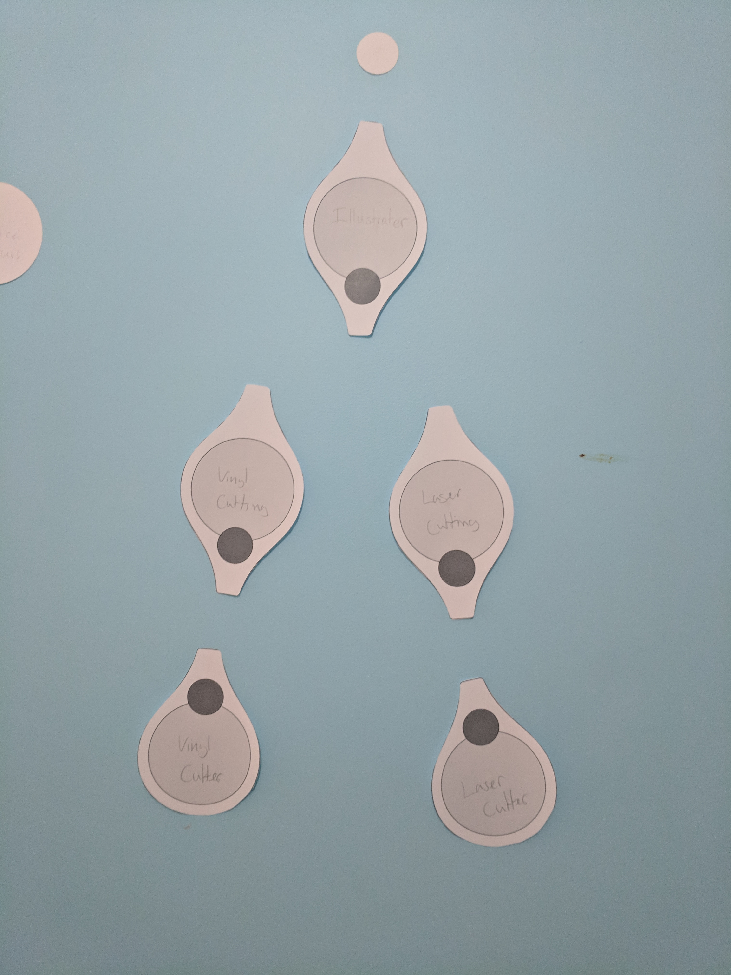
[picture p41: docs/assets/paper4.jpg]
paper4

A more interesting layout, much less grid like.

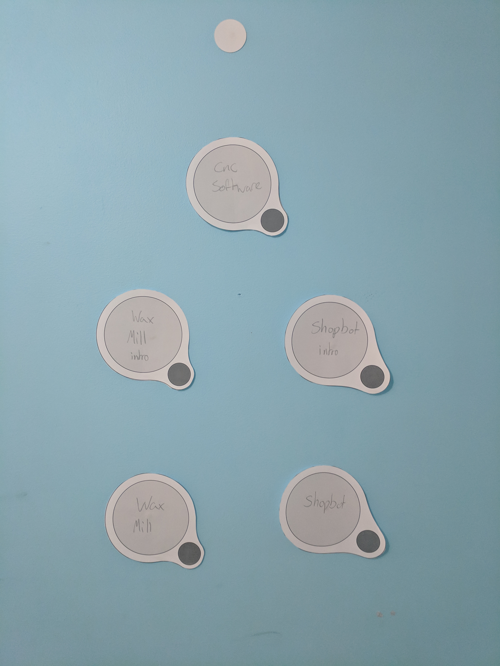
[picture p42: docs/assets/paper5.jpg]
paper5

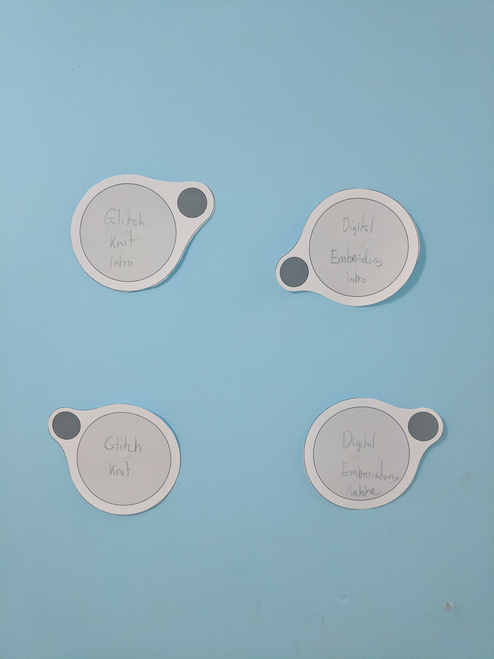
[picture p43: docs/assets/paper7.jpg]
paper7


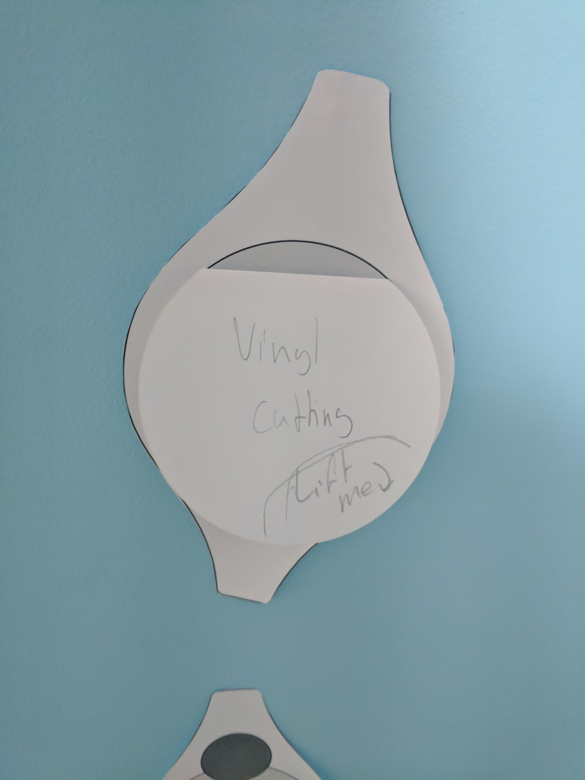
[picture p44: docs/assets/paper8.jpg]
paper8

To add more information I could add a flap system.

## Electronics

### Selecting a method
#### Node Based Micro-controllers
To allow for modularity the wall could be designed into sections each stemming off a node. Each node will contain a micro-controller and communicate with the base node.

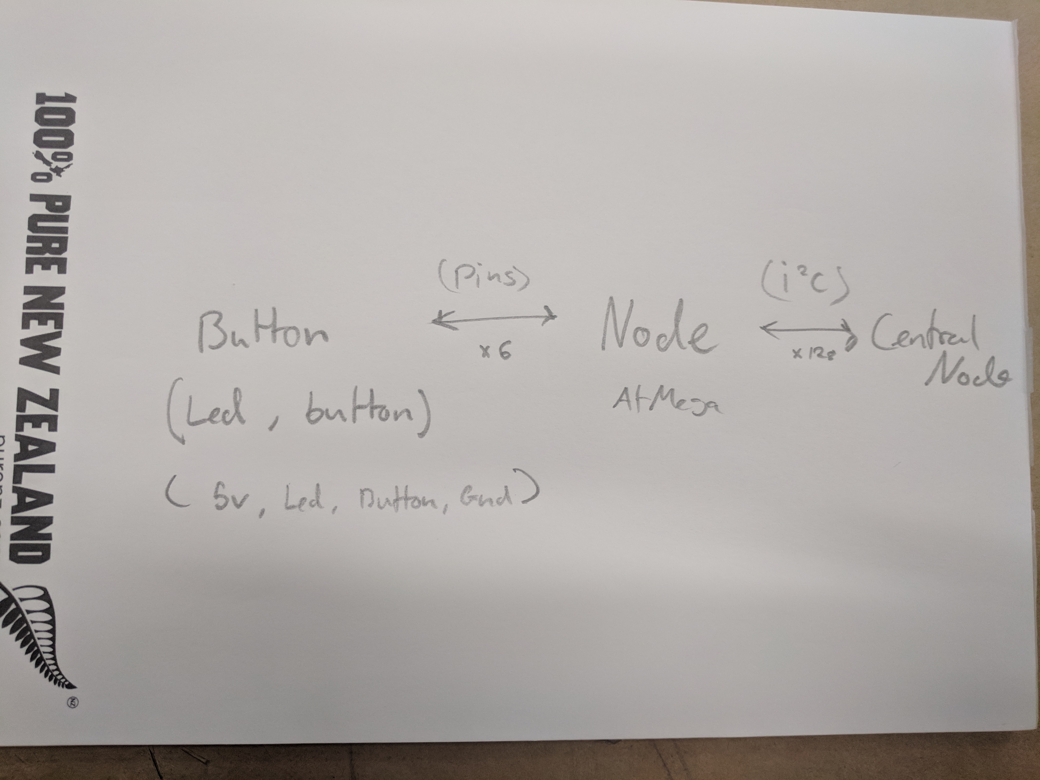
[picture p45: docs/assets/electronics3.jpg]
electronics3

##### Proof of Concept
For a proof of concept, I used 3 Arduino Unos and wrote some [code (basic i2c)](https://github.com/harryiliffe/interactive-wall/tree/master/code/testing/basic%20i2c).
The Arduinos communicate through i2c which allows for 2 way communication for the LEDs and buttons.
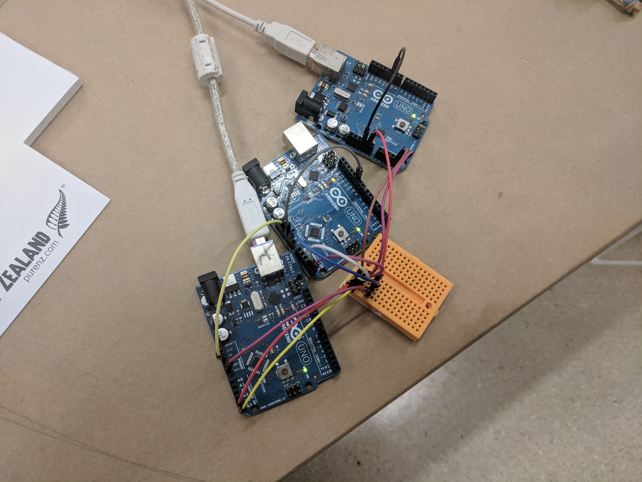
[picture p46: docs/assets/electronics1.jpg]
electronics1

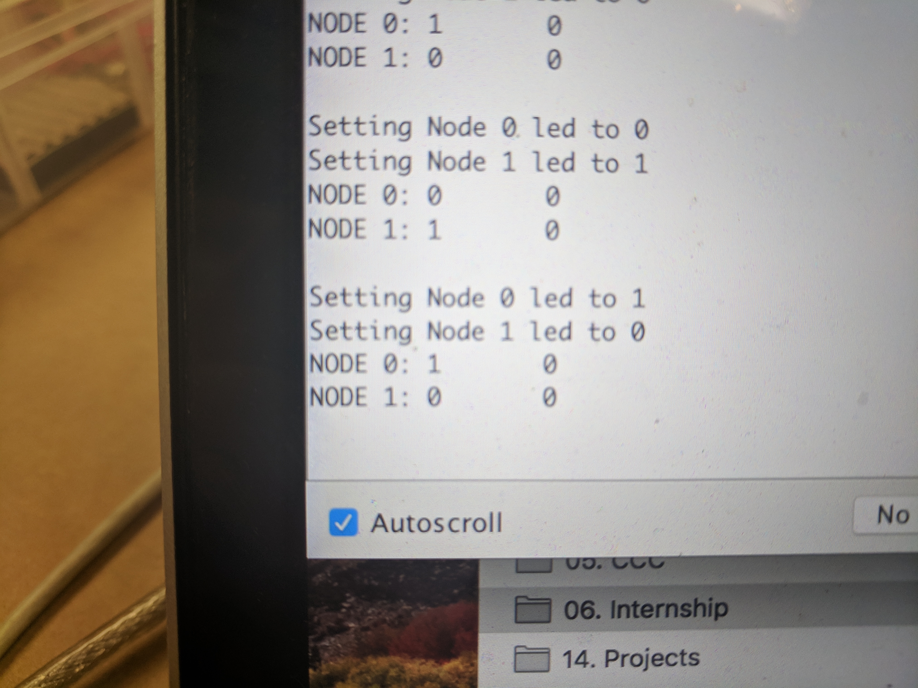
[picture p47: docs/assets/electronics2.jpg]
electronics2


The proof of concept worked really well and with a little bit more work I will be able to create an easy to read library for communicating between the Central Node and the Nodes.

#### Hub Based Micro-controllers
A different, cheaper way of designing the system would be to have a single micro-controller in the hub with wires running to each button to allow for the Buttons and LEDs. Although this will mean a lot of wires running from the hub it will make a number of things easier.

##### Proof of Concept
A major concern with this design is that the capacitive touch and LEDs will not work at the maximum distance. To test this I got a 4.5m wire.
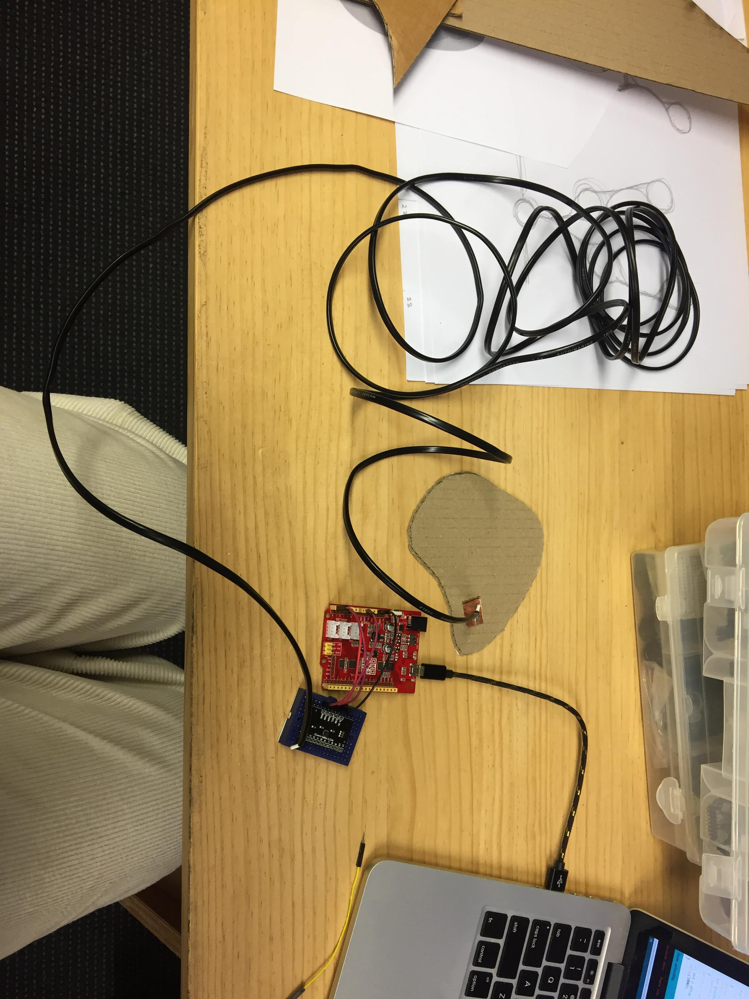
[picture p48: docs/assets/electronics4.jpg]
electronics4

The Capacitive touch worked well.
