harryiliffe/interactive-wall/docs/_pages/todo.md

---
title: "To Do list"
layout: default
---

 * Work out current issues and solutions

 * Wall Panels (2 Remain)
 * Button Modules ()
 * Finalise Circuit Boards

 * Order components (Capacitive touch boards from Adafruit, PCBs, Cables, JST Connectors, SMD components)
