harryiliffe/interactive-wall/boards/compute hub - atmega/compute hub.brd

## EAGLE design boards/compute hub - atmega/compute hub.brd (2019-12-14)

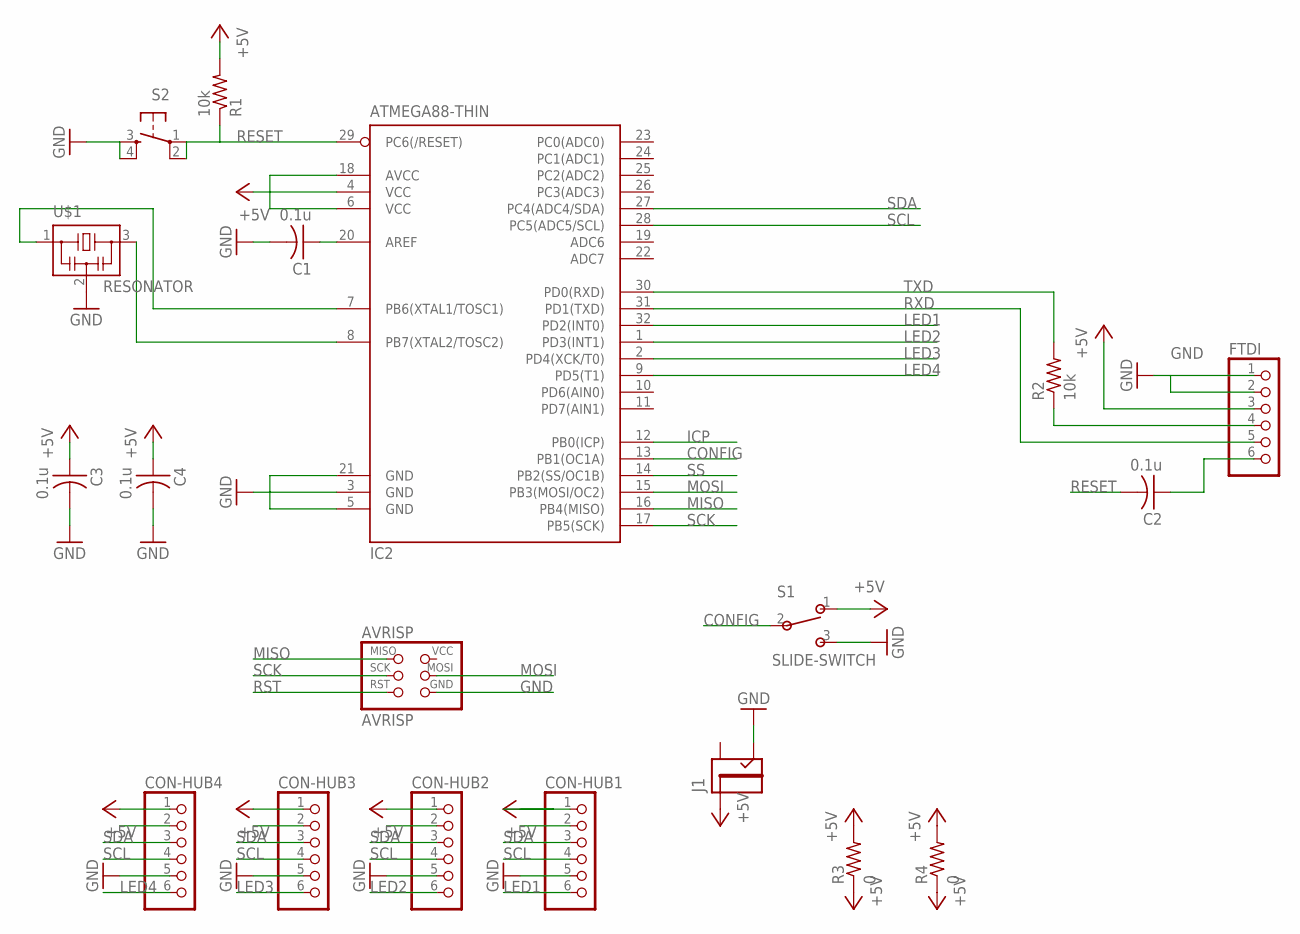
[picture p49: schematic compute hub.sch]

Parts:
AVRISP: AVRISP; 2X03
C1, C2, C3, C4: 0.1u; C1206FAB
CON-HUB1, CON-HUB2, CON-HUB3, CON-HUB4: PINHD-1X6; 1X06
FTDI: PINHD-1X6; 1X06
IC2: ATMEGA88-THIN; TQFP32-08THIN
J1: JACK2.1MM; JACK_2.1MM
R1, R2: 10k; R1206FAB
R3, R4: 0; R1206FAB
S1: SLIDE-SWITCH; AYZ0102AGRLC
S2: 6MM_SWITCH6MM_SWITCH; 6MM_SWITCH
U$1: RESONATOR; EFOBM

Connections:
+5V: C3.1, C4.1, CON-HUB1.1, CON-HUB2.1, CON-HUB3.1, CON-HUB4.1, FTDI.3, IC2.4 (VCC), IC2.6 (VCC), IC2.18 (AVCC), J1.PIN, R1.2, R3.1, R3.2, R4.1, R4.2
CONFIG: IC2.13 (PB1(OC1A)), S1.2
GND: AVRISP.6 (GND), C1.2, C3.2, C4.2, CON-HUB1.5, CON-HUB2.5, CON-HUB3.5, CON-HUB4.5, FTDI.1, FTDI.2, IC2.3 (GND), IC2.5 (GND), IC2.21 (GND), J1.CONTACT, S1.3, S2.3 (S), S2.4 (S1), U$1.2
ICP: IC2.12 (PB0(ICP))
LED1: CON-HUB1.6, IC2.32 (PD2(INT0))
LED2: CON-HUB2.6, IC2.1 (PD3(INT1))
LED3: CON-HUB3.6, IC2.2 (PD4(XCK/T0))
LED4: CON-HUB4.6, IC2.9 (PD5(T1))
MISO: AVRISP.1 (MISO), IC2.16 (PB4(MISO))
MOSI: AVRISP.4 (MOSI), IC2.15 (PB3(MOSI/OC2))
unnamed: C1.1, IC2.20 (AREF)
unnamed: IC2.8 (PB7(XTAL2/TOSC2)), U$1.3
unnamed: IC2.7 (PB6(XTAL1/TOSC1)), U$1.1
unnamed: FTDI.4, R2.1
unnamed: C2.1, FTDI.6
RESET: C2.2, IC2.29 (PC6(/RESET)), R1.1, S2.1, S2.2 (P1)
RST: AVRISP.5 (RST)
RXD: FTDI.5, IC2.31 (PD1(TXD))
SCK: AVRISP.3 (SCK), IC2.17 (PB5(SCK))
SCL: CON-HUB1.4, CON-HUB2.4, CON-HUB3.4, CON-HUB4.4, IC2.28 (PC5(ADC5/SCL))
SDA: CON-HUB1.3, CON-HUB2.3, CON-HUB3.3, CON-HUB4.3, IC2.27 (PC4(ADC4/SDA))
SS: IC2.14 (PB2(SS/OC1B))
TXD: IC2.30 (PD0(RXD)), R2.2

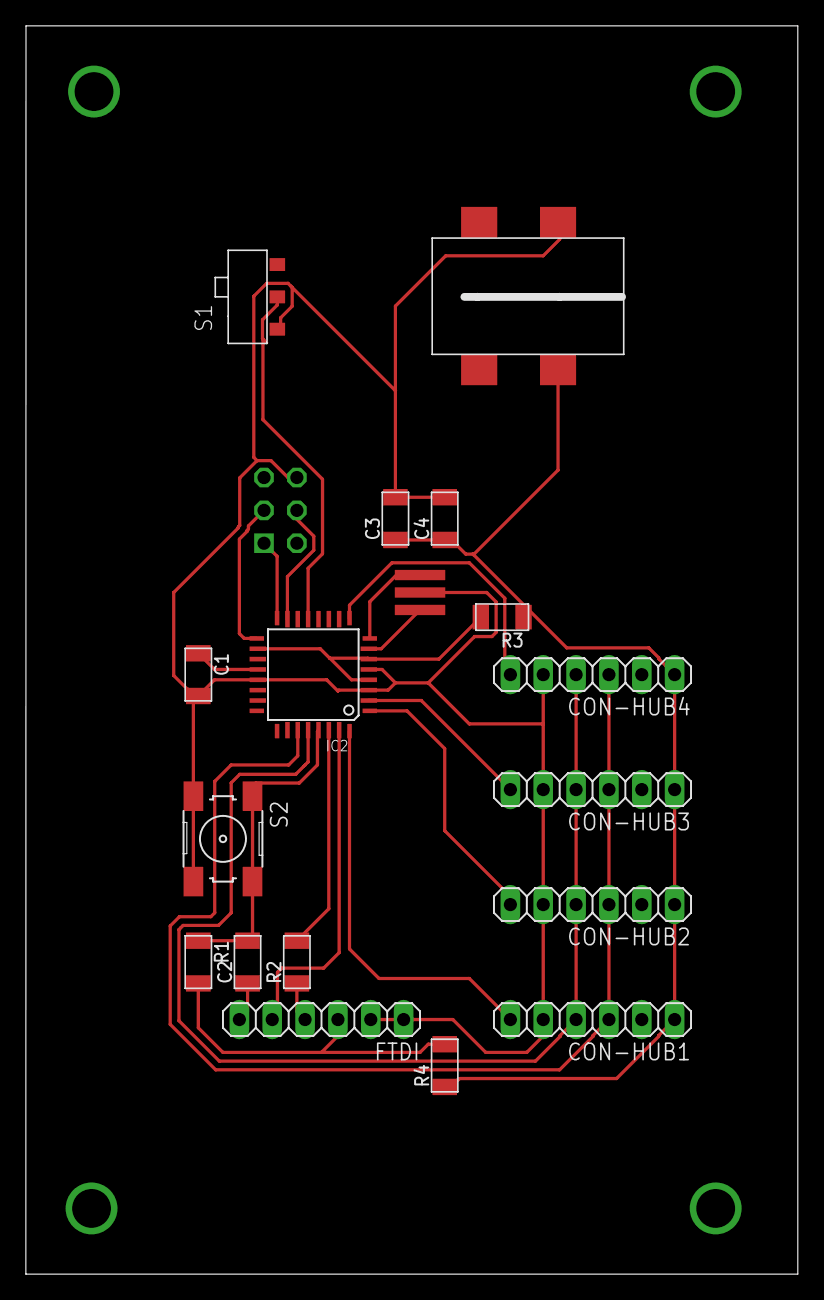
[picture p50: board boards/compute hub - atmega/compute hub.brd from above]

Board: 2 copper layers, 59.7 x 96.5 mm, 19 parts (1 on the bottom side), 20 nets.
