harryiliffe/interactive-wall/boards/compute hub/compute hub.brd

## EAGLE design boards/compute hub/compute hub.brd (2019-02-11)

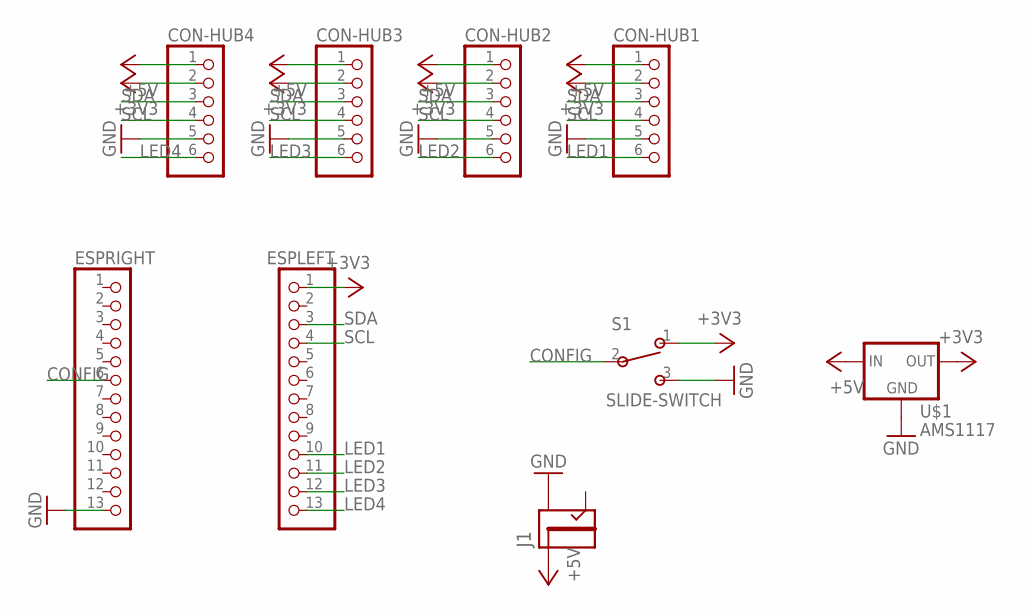
[picture p51: schematic compute hub.sch]

Parts:
CON-HUB1, CON-HUB2, CON-HUB3, CON-HUB4: PINHD-1X6; 1X06
ESPLEFT: PINHD-1X13; 1X13
ESPRIGHT: PINHD-1X13; 1X13
J1: JACK2.1MM; JACK_2.1MM
S1: SLIDE-SWITCH; AYZ0102AGRLC
U$1: AMS1117; SOT223

Connections:
+3V3: CON-HUB1.2, CON-HUB2.2, CON-HUB3.2, CON-HUB4.2, ESPLEFT.1, S1.1, U$1.2 (OUT)
+5V: CON-HUB1.1, CON-HUB2.1, CON-HUB3.1, CON-HUB4.1, J1.PIN, U$1.3 (IN)
CONFIG: ESPRIGHT.6, S1.2
GND: CON-HUB1.5, CON-HUB2.5, CON-HUB3.5, CON-HUB4.5, ESPRIGHT.13, J1.SHUNT, S1.3, U$1.1 (GND)
LED1: CON-HUB1.6, ESPLEFT.10
LED2: CON-HUB2.6, ESPLEFT.11
LED3: CON-HUB3.6, ESPLEFT.12
LED4: CON-HUB4.6, ESPLEFT.13
SCL: CON-HUB1.4, CON-HUB2.4, CON-HUB3.4, CON-HUB4.4, ESPLEFT.4
SDA: CON-HUB1.3, CON-HUB2.3, CON-HUB3.3, CON-HUB4.3, ESPLEFT.3

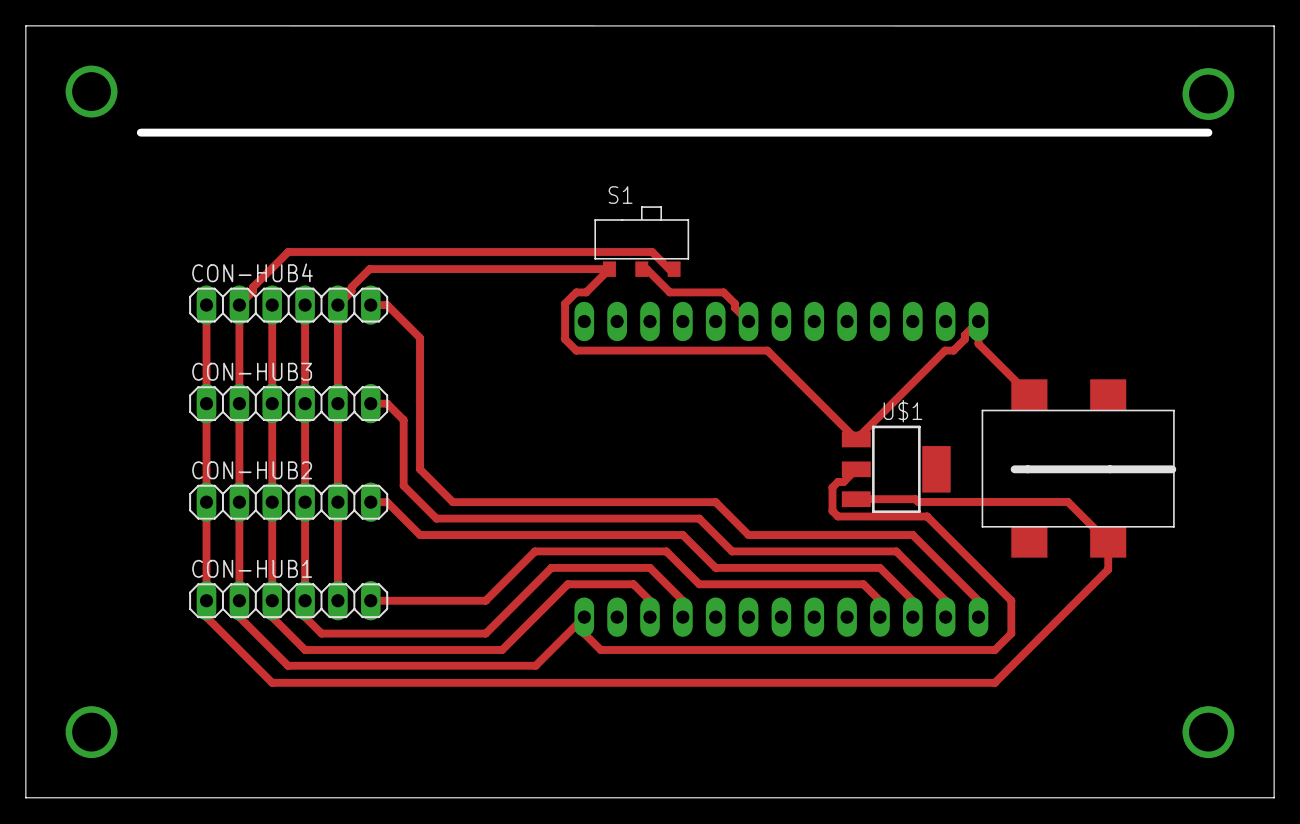
[picture p52: board boards/compute hub/compute hub.brd from above]

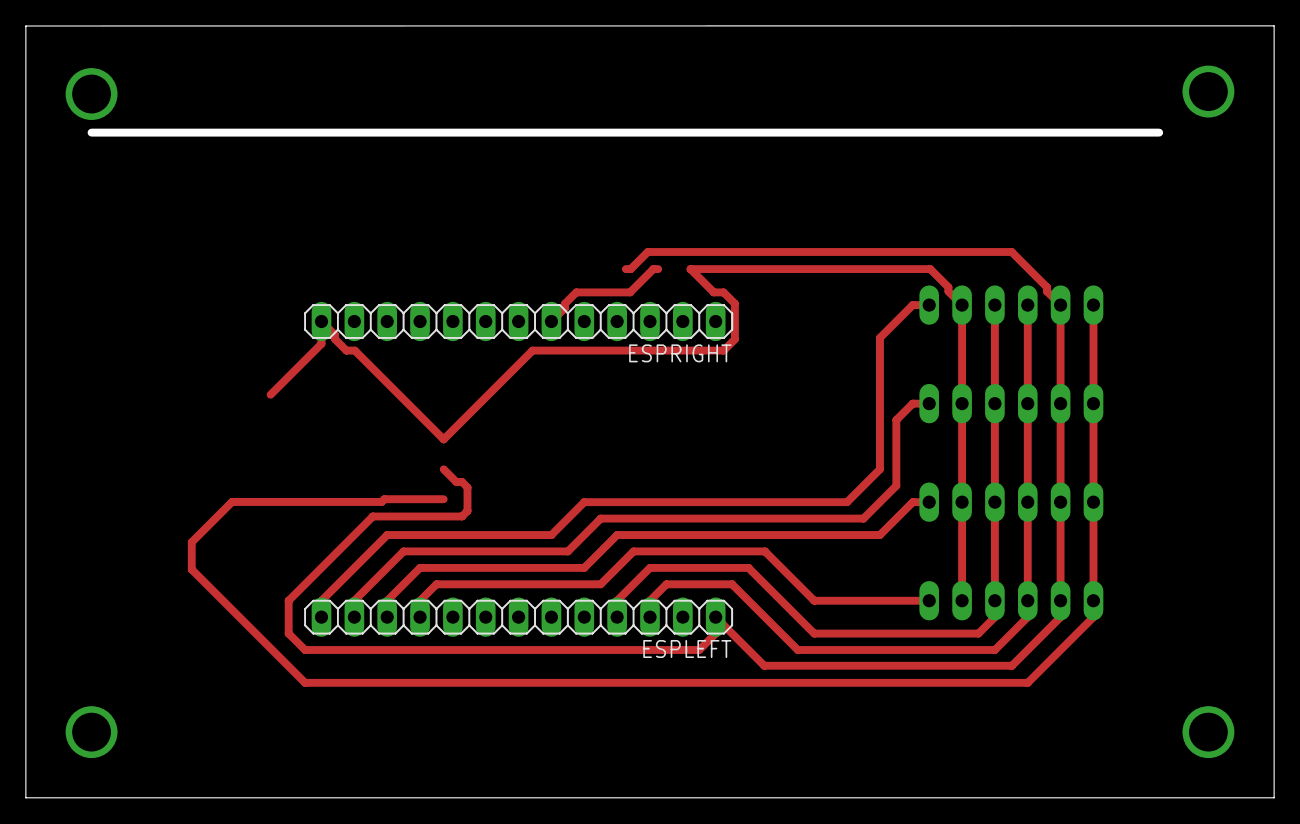
[picture p53: board boards/compute hub/compute hub.brd from below]

Board: 2 copper layers, 96.5 x 59.7 mm, 9 parts (2 on the bottom side), 10 nets.
