harryiliffe/interactive-wall/boards/capactive hub/capactive hub.brd

## EAGLE design boards/capactive hub/capactive hub.brd (2019-02-11)

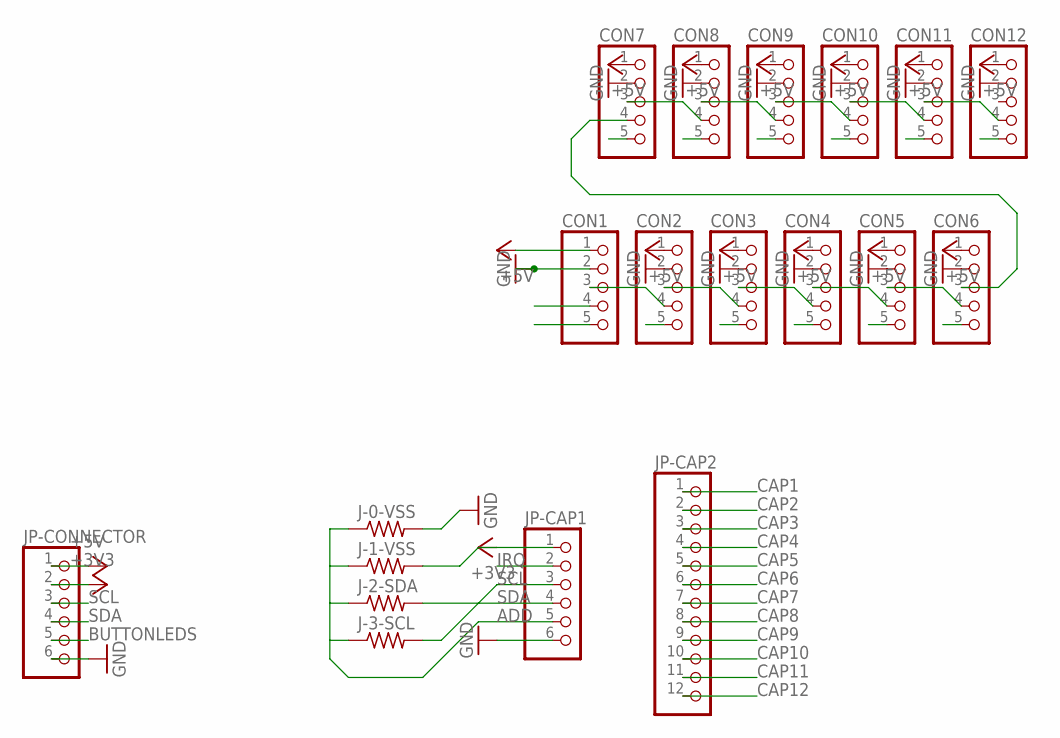
[picture p54: schematic capactive hub.sch]

Parts:
CON1, CON2, CON3, CON4, CON5, CON6, CON7, CON8, CON9, CON10, CON11, CON12: PINHD-1X5; 1X05
J-0-VSS, J-1-VSS, J-2-SDA, J-3-SCL: RES-US1206FAB; R1206FAB
JP-CAP1: PINHD-1X6; 1X06
JP-CAP2: PINHD-1X12; 1X12
JP-CONNECTOR: PINHD-1X6; 1X06

Connections:
+3V3: J-1-VSS.2, JP-CAP1.1, JP-CONNECTOR.2
+5V: CON1.1, CON2.1, CON3.1, CON4.1, CON5.1, CON6.1, CON7.1, CON8.1, CON9.1, CON10.1, CON11.1, CON12.1, JP-CONNECTOR.1
ADD: J-0-VSS.1, J-1-VSS.1, J-2-SDA.1, J-3-SCL.1, JP-CAP1.5
BUTTONLEDS: CON1.4, JP-CONNECTOR.5
CAP1: CON1.5, JP-CAP2.1
CAP2: CON2.5, JP-CAP2.2
CAP3: CON3.5, JP-CAP2.3
CAP4: CON4.5, JP-CAP2.4
CAP5: CON5.5, JP-CAP2.5
CAP6: CON6.5, JP-CAP2.6
CAP7: CON7.5, JP-CAP2.7
CAP8: CON8.5, JP-CAP2.8
CAP9: CON9.5, JP-CAP2.9
CAP10: CON10.5, JP-CAP2.10
CAP11: CON11.5, JP-CAP2.11
CAP12: CON12.5, JP-CAP2.12
GND: CON1.2, CON2.2, CON3.2, CON4.2, CON5.2, CON6.2, CON7.2, CON8.2, CON9.2, CON10.2, CON11.2, CON12.2, J-0-VSS.2, JP-CAP1.6, JP-CONNECTOR.6
IRQ: JP-CAP1.2
LEDOUT: CON1.3, CON2.4
unnamed: CON2.3, CON3.4
unnamed: CON3.3, CON4.4
unnamed: CON4.3, CON5.4
unnamed: CON5.3, CON6.4
unnamed: CON6.3, CON7.4
unnamed: CON7.3, CON8.4
unnamed: CON8.3, CON9.4
unnamed: CON9.3, CON10.4
unnamed: CON10.3, CON11.4
unnamed: CON11.3, CON12.4
SCL: J-3-SCL.2, JP-CAP1.3, JP-CONNECTOR.3
SDA: J-2-SDA.2, JP-CAP1.4, JP-CONNECTOR.4

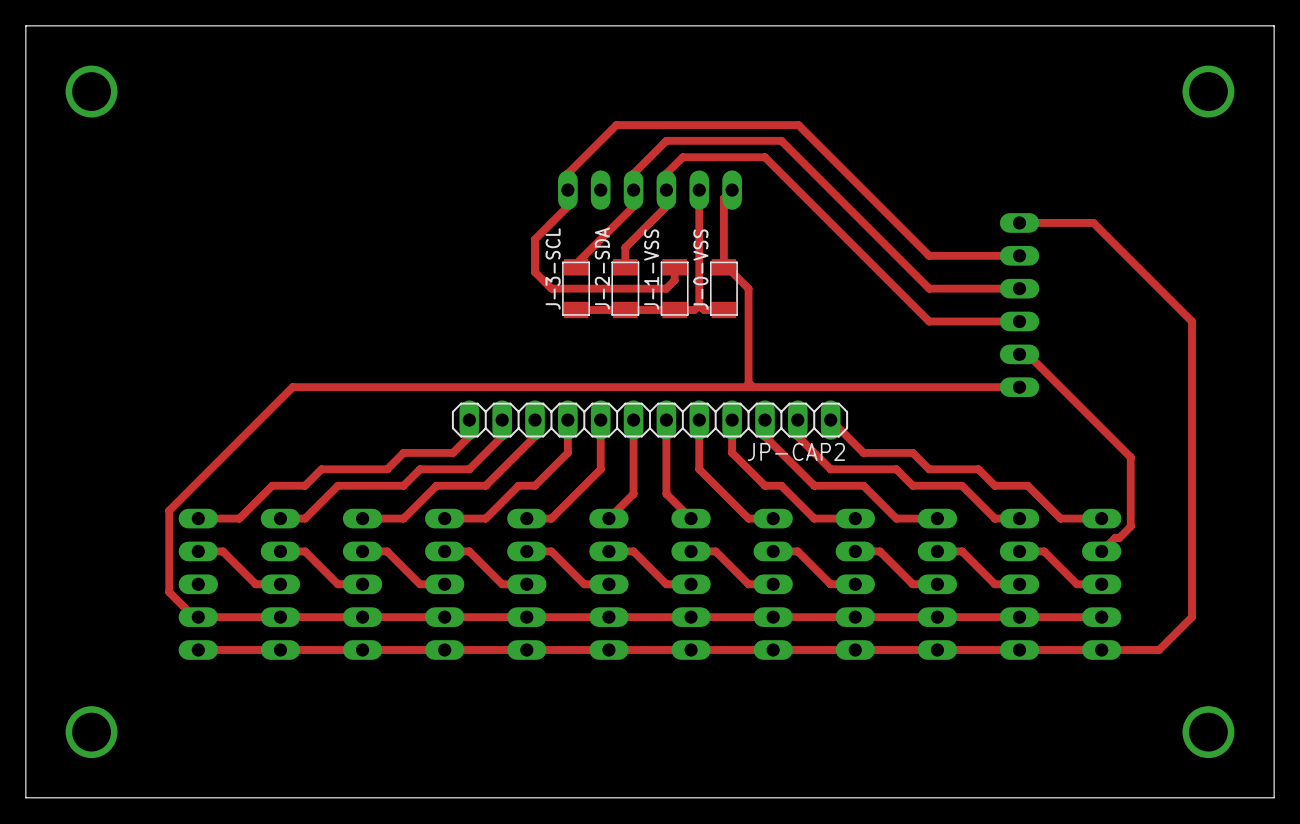
[picture p55: board capactive hub.brd from above]

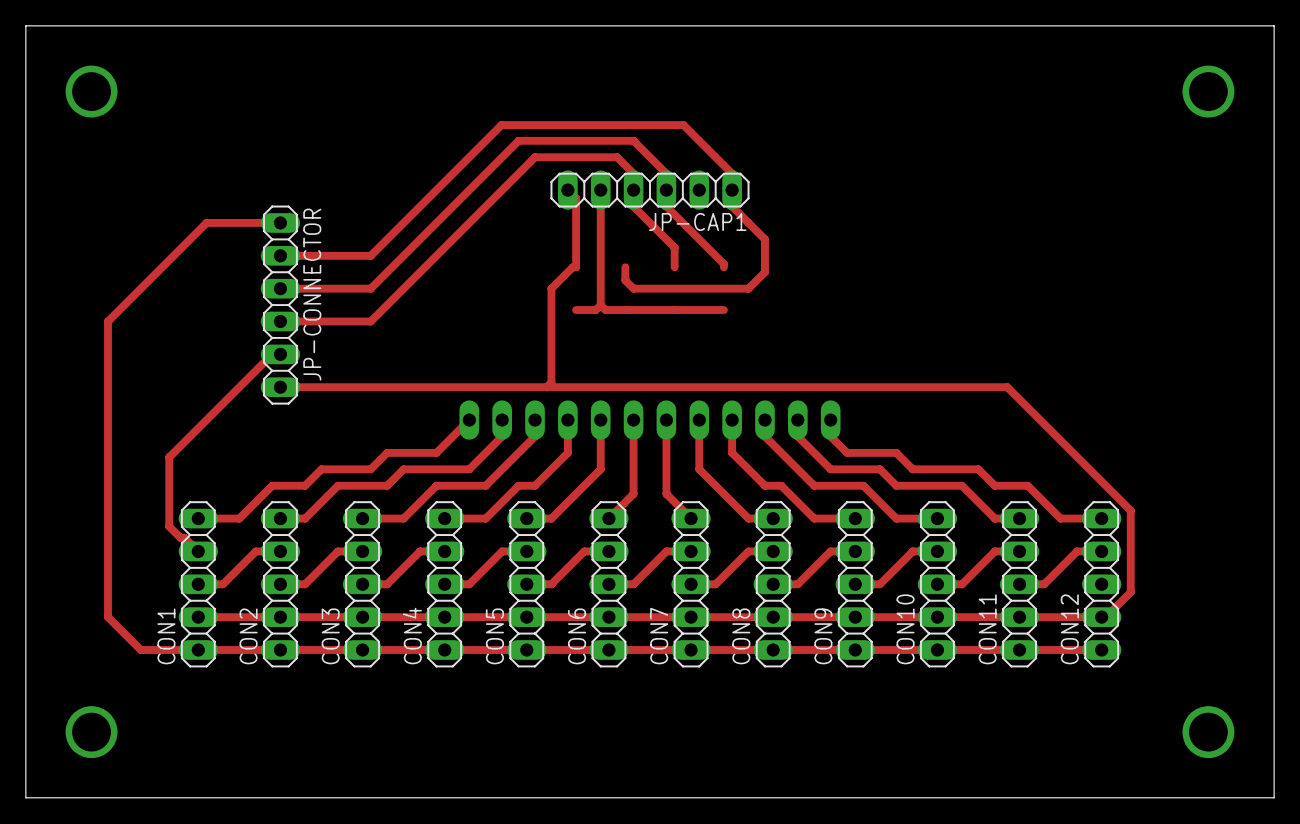
[picture p56: board capactive hub.brd from below]

Board: 2 copper layers, 96.5 x 59.7 mm, 19 parts (14 on the bottom side), 30 nets.
