harryiliffe/interactive-wall/boards/led bar/led bar.brd

## EAGLE design boards/led bar/led bar.brd (2018-12-14)

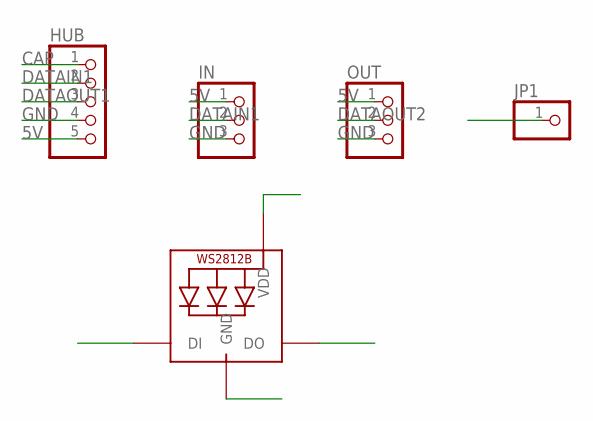
[picture p57: schematic led bar.sch]

Parts:
HUB: PINHD-1X5; 1X05
IN: PINHD-1X3; 1X03
JP1: PINHD-1X1; 1X01
LED1: WS2812B5050; WS2812B
OUT: PINHD-1X3; 1X03

Connections:
5V: HUB.5, IN.1, LED1.1-VDD (VDD), OUT.1
CAP: HUB.1
DATAIN1: HUB.2, IN.2, LED1.4-DIN (DI)
DATAOUT1: HUB.3, JP1.1
DATAOUT2: LED1.2-DOUT (DO), OUT.2
GND: HUB.4, IN.3, LED1.3-GND (GND), OUT.3

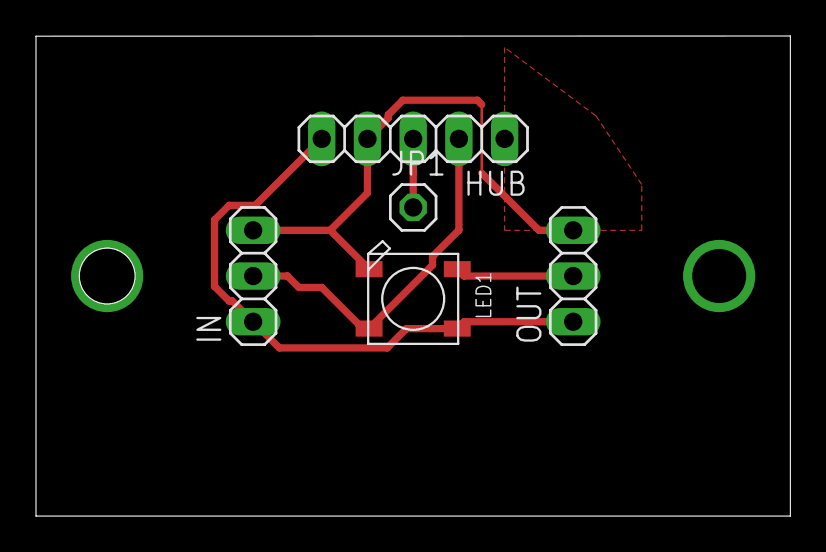
[picture p58: board led bar.brd from above]

Board: 2 copper layers, 41.9 x 26.7 mm, 5 parts (0 on the bottom side), 5 nets.
