harryiliffe/interactive-wall/boards/button module/button module.brd

## EAGLE design boards/button module/button module.brd (2018-12-11)

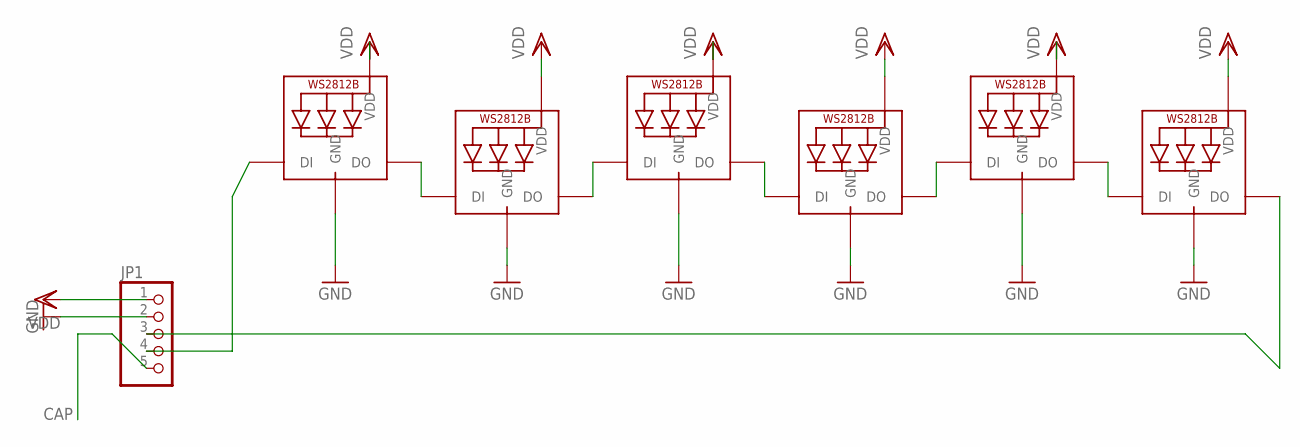
[picture p59: schematic button module.sch]

Parts:
JP1: PINHD-1X5; 1X05
LED1, LED2, LED3, LED4, LED5, LED6: WS2812B5050; WS2812B

Connections:
CAP: JP1.5
GND: JP1.2, LED1.3-GND (GND), LED2.3-GND (GND), LED3.3-GND (GND), LED4.3-GND (GND), LED5.3-GND (GND), LED6.3-GND (GND)
unnamed: JP1.4, LED1.4-DIN (DI)
unnamed: JP1.3, LED6.2-DOUT (DO)
unnamed: LED1.2-DOUT (DO), LED2.4-DIN (DI)
unnamed: LED2.2-DOUT (DO), LED3.4-DIN (DI)
unnamed: LED3.2-DOUT (DO), LED4.4-DIN (DI)
unnamed: LED4.2-DOUT (DO), LED5.4-DIN (DI)
unnamed: LED5.2-DOUT (DO), LED6.4-DIN (DI)
VDD: JP1.1, LED1.1-VDD (VDD), LED2.1-VDD (VDD), LED3.1-VDD (VDD), LED4.1-VDD (VDD), LED5.1-VDD (VDD), LED6.1-VDD (VDD)

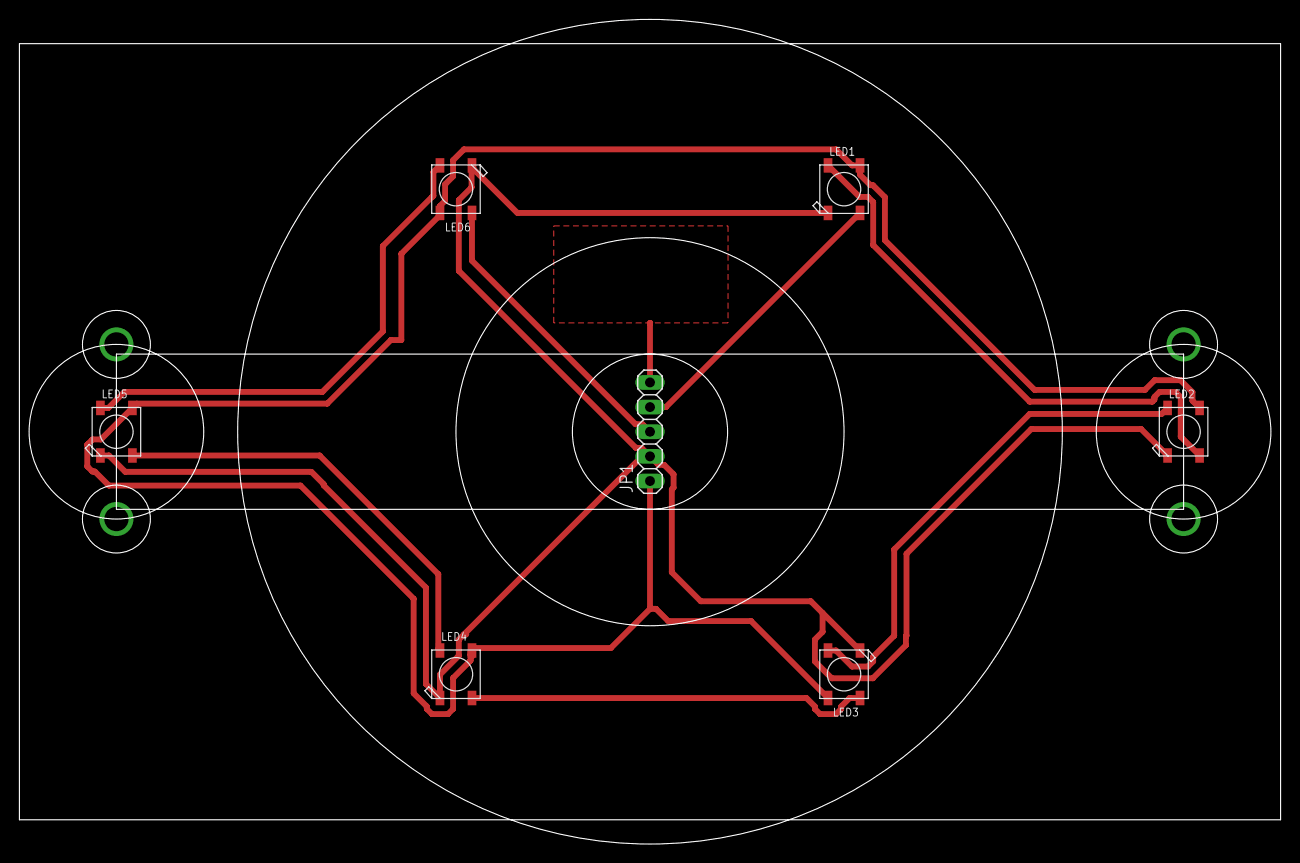
[picture p60: board button module.brd from above]

Board: 2 copper layers, 130.0 x 85.0 mm, 7 parts (0 on the bottom side), 9 nets.
