harryiliffe/interactive-wall/(commit log)

2018-11-16 created basic i2c example
2018-11-16 added electronics and different button shapes
2018-12-04 added boards and extended materials list
    [led buttons.brd, led buttons.sch]
2018-12-11 updated boards
    [button module.brd, button module.sch, capactive hub.brd, capactive hub.sch, compute hub.brd, compute hub.sch, led buttons.brd, led buttons.sch]
2018-12-13 added led bar support
2018-12-14 added led bar circuit board
    [led bar.brd, led bar.sch]
2019-02-08 added atmega compute board
    [compute hub.brd, compute hub.sch]
2019-02-11 updated circuit board designs
    [capactive hub.brd, capactive hub.sch, compute hub.brd, compute hub.sch]
2019-03-11 updated circuits, added test files, fixed images.
    [capactive hub.brd, capactive hub.sch, compute hub.brd, compute hub.sch]
2019-12-14 updated docs && circuit board
    [compute hub.brd, compute hub.sch]
